lcg-l/HTDW_Opendog/urdf模型/xlerobot/xlerobot-HT 物料明细表.XLSX

xlerobot-HT 物料清单
序号 | !缩略图 | !文件名 | !统计数量 | 零件类型 | 零件数量
1 |  | link2 | 1
2 |  | 5036-02-正装 | 1
3 |  | Link2_Cover_A_V2.0 | 1
4 |  | 4438_model | 3
5 |  | 4438_Stator_block_1 | 3
6 |  | Link2_Connect_1免弯折 | 1
7 |  | Link2_Connect_2免弯折 | 1
8 |  | Link2_Cover_B_V2.0免弯折 | 1
9 |  | Bearing30x37x4
10 |  | 4438_Stator_block_B_2 | 3
11 |  | link1 | 1
12 |  | Link1_Connect_1 | 1
13 |  | Link1_Connect_2 | 1
14 |  | L1_Inner_circle_B | 1
15 |  | Link1_L1_D | 1
16 |  | 4438_Rotor_block_1 | 3
17 |  | 4438_Stator_block_B | 3
18 |  | link3 | 1
19 |  | Link3_Connect_3 | 1
20 |  | Link3_Connect_1免弯折 | 1
21 |  | Link3_Connect_2免弯折 | 1
22 |  | Link3_Connect_B3免折弯 | 1
23 |  | link4 | 1
24 |  | Link4_Connect_1 | 1
25 |  | 3536_model | 2
26 |  | Link4_libe_buckle | 1
27 |  | link5 | 1
28 |  | Link6_Connect_1 | 1
29 |  | Link5_Connect_3 | 1
30 |  | 2×6销轴 | 1
31 |  | Link5_Connect_2改件 | 1
32 |  | link6 | 1
33 |  | Gripper_Assembly | 1
34 |  | Gripper_Connect_B | 1
35 |  | hightorque3536 | 1
36 |  | MGN9-C | 2
37 |  | MGN9 Rail | 1
38 |  | Gripper_Connect_C | 2
39 |  | Gripper_Connect_D | 2
40 |  | Shoulder_Bolt_4xM3x7 | 4
41 |  | Flanged_Bearing4x9x2.5 | 8
42 |  | Gripper_Connect_A | 1
43 |  | Gripper_finger_Flexible_umi | 2
44 |  | hex_socket_flat_head_M3x08 | 4
45 |  | hex_socket_low_button_head_M3x8 | 3
46 |  | hex_socket_low_button_head_M3x5 | 8
47 |  | gripper_connect_R | 1
48 |  | gripper_connect_L | 1
49 |  | Gripper_Connect_E1.1 | 2
50 |  | RealSense_D405 | 1
51 |  | L6_Claw_insertsB | 1
52 |  | L6_Claw_insertsC | 1
53 |  | L6_Claw_insertsA | 1
54 |  | Link1_L6_A- | 1
55 |  | Gripper-Camera_Connect_A- | 1
56 |  | Gripper_Connect_F- | 1
57 |  | base_link | 1
58 |  | Baselink_1 | 1
59 |  | Baselink_C-3.0 | 1
60 |  | L1_Inner_circleV2.0 | 1
61 |  | 底座带新LOGO丝印- | 1
62 |  | HTDW-4530-02-CNE | 1
63 |  | HTDW-4530-02-CNE.STEP | 1
64 |  | 4438外壳03192.0.STEP | 1
65 |  | 4438-电机盖-2.1.STEP | 1
66 |  | 4438-jc轴承座-1.3.STEP | 1
67 |  | 4438-jc输出盘.STEP | 1
68 |  | CRBT305A 30-41-5交叉滚子轴承.STEP | 1
69 |  | 2内齿44382.0.STEP | 1
70 |  | 3D_双编-4438-V1.9_2025-03-042.0.STEP | 1
71 |  | 4438输出编码器销2.0_35.5.STEP | 1
72 |  | M2.5-10-3.7杯头螺丝.STEP | 4
73 |  | m2-4-3十字沉头螺丝.STEP | 4
74 |  | 30-40-3旋转油封.STEP | 1
