lcg-l/HTDW_Opendog/四足-姚旋-5套/四足-姚旋-5套.xlsx

零件名称： |  |  |  | 备注
输出人： | 姚旋
输出时间： | 2026-09-01
零件级别 | 零件名称 | 图样 | 单套数量 | 套数 | 总数量 | 材质名称 | 备注
 | 大腿内侧-L |  | 2 | 5 | 10 | 6061合金
 | 大腿内侧-R |  | 2 | 5 | 10 | 6061合金
 | 大腿外侧-L |  | 2 | 5 | 10 | 6061合金
 | 大腿外侧-R |  | 2 | 5 | 10 | 6061合金
 | 4530快拆法兰-A |  | 8 | 5 | 40 | 6061合金
 | 横梁 |  | 2 | 5 | 10 | 6061合金
 | 髋关节快拆 |  | 4 | 5 | 20 | 6061合金
 | 钢连杆 |  | 4 | 5 | 20 | 7075合金
 | 箱体侧板 |  | 2 | 5 | 10 | 6061合金
 | 摇臂 |  | 4 | 5 | 20 | 45钢
 | 4530快拆法兰-B |  | 8 | 5 | 40 | 6061合金
 | 4530快拆法兰-C |  | 4 | 5 | 20 | 6061合金
 | 钣金快拆 |  | 2 | 5 | 10 | 镀锌板
 | 限位块 |  | 8 | 5 | 40 | 6061合金
 | 大腿限位块 |  | 8 | 5 | 40 | 6061合金
 | 钣金快拆垫块 |  | 4 | 5 | 20 | 6061合金
