lcg-l/HTDW_Opendog/urdf模型/xlerobot/forearm_link.SLDASM

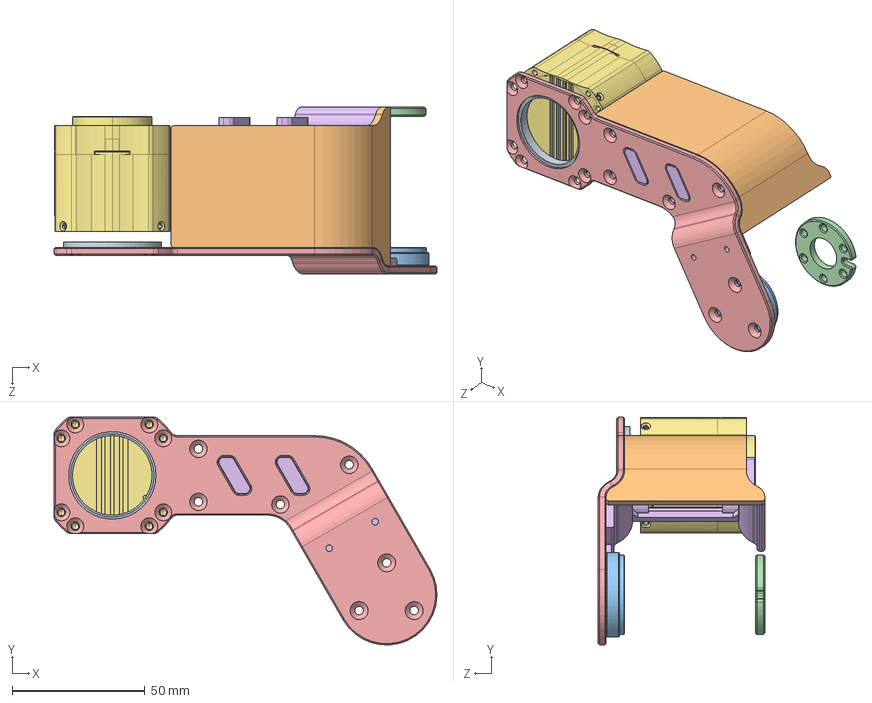
[picture p1: CAD file, 2026-08-31]
urdf模型/xlerobot/forearm_link.SLDASM
144.5 x 86.0 x 62.9 mm
4438_model
Link3_Connect_3
Link3_Connect_1免弯折
4438_Rotor_block_1
4438_Stator_block_B
Link3_Connect_B3免折弯
Bearing30x37x4
