lcg-l/HTDW_Opendog/模型/hip.SLDASM

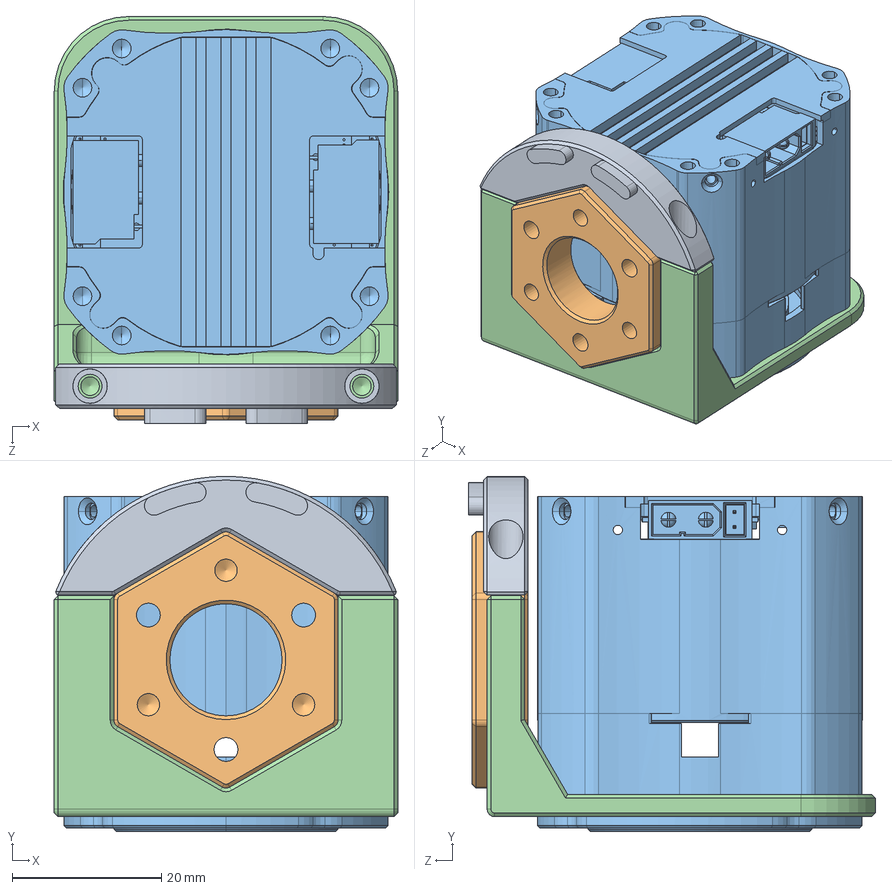
[picture p2: CAD file, 2026-08-31]
模型/hip.SLDASM
46.0 x 47.6 x 54.5 mm
髋关节快拆
4438-JC正装模型
4530快拆法兰-A
4530快拆法兰-B
