lcg-l/HTDW_Opendog/ri_4438/meshes/base_link_part_2.STL

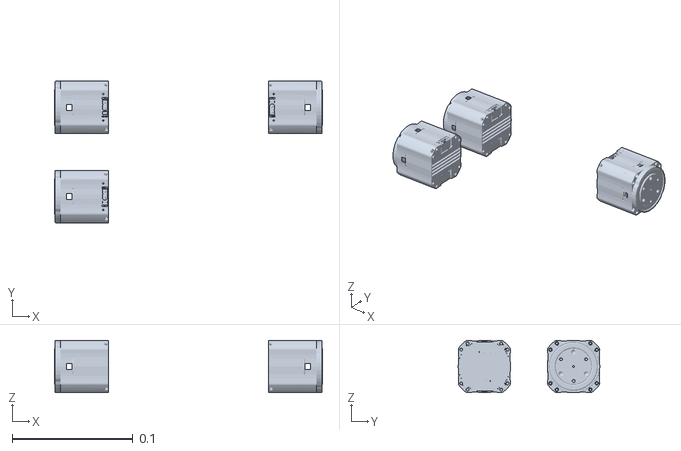
[picture p3: CAD file, 2026-08-03]
ri_4438/meshes/base_link_part_2.STL
0.222 x 0.117 x 0.0435
