lcg-l/HTDW_Opendog/ri_plus_4438/meshes/gripper_finger_right.STL

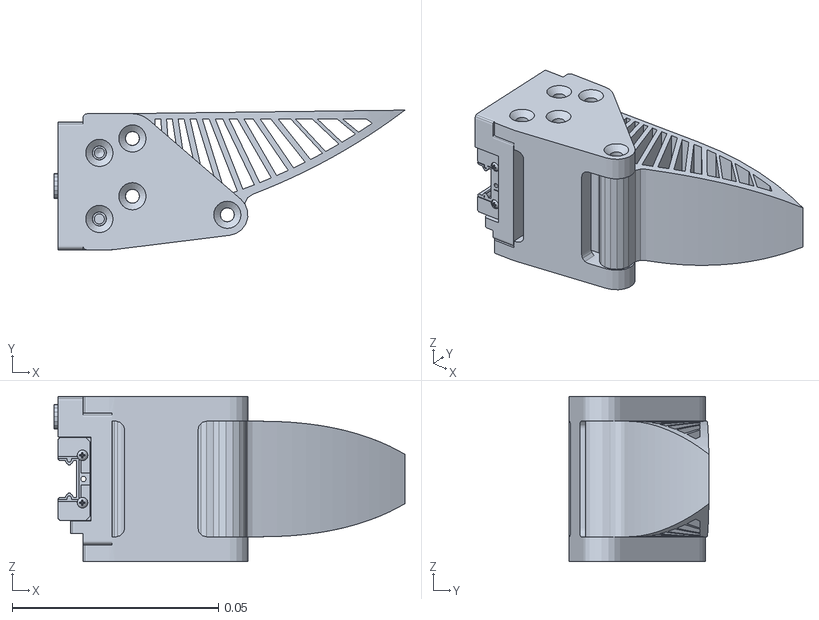
[picture p4: CAD file, 2026-08-04]
ri_plus_4438/meshes/gripper_finger_right.STL
0.0851 x 0.0339 x 0.04
