lcg-l/HTDW_Opendog/urdf/小腿.SLDPRT

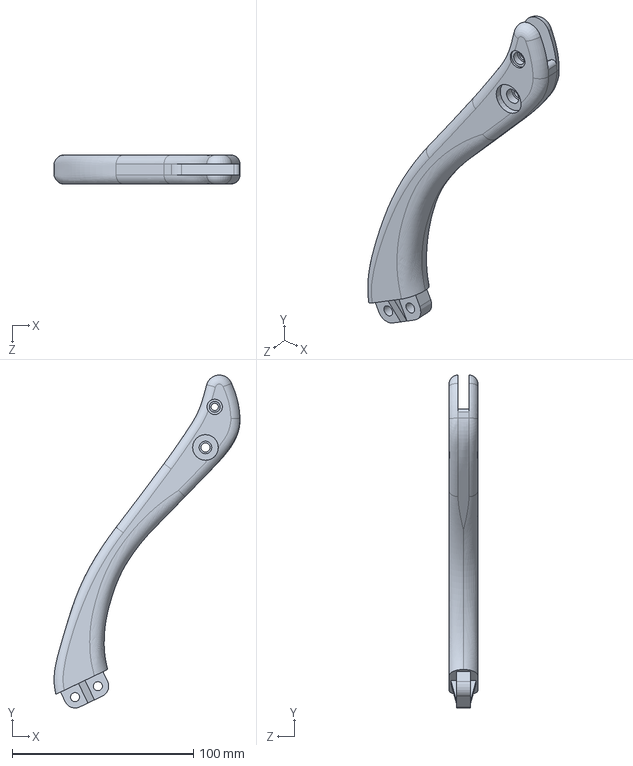
[picture p5: CAD file, 2026-07-23]
urdf/小腿.SLDPRT
102.7 x 183.9 x 16.0 mm
