lcg-l/HTDW_Opendog/urdf模型/箱体侧板.SLDPRT

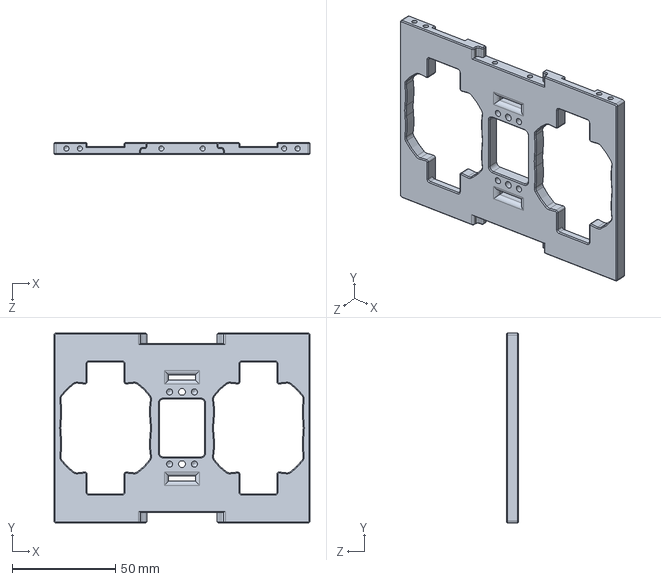
[picture p6: CAD file, 2026-09-02]
urdf模型/箱体侧板.SLDPRT
124.0 x 92.0 x 6.00 mm
