lcg-l/HTDW_Opendog/四足-姚旋-5套/step/箱体侧板.step

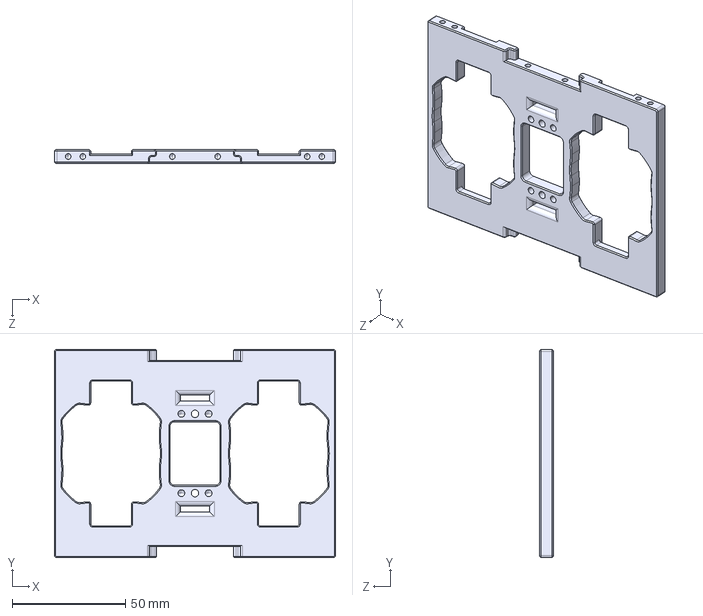
[picture p7: CAD file, 2026-09-02]
四足-姚旋-5套/step/箱体侧板.step
124.0 x 92.0 x 6.00 mm
