lcg-l/HTDW_Opendog/模型/摇臂.SLDPRT

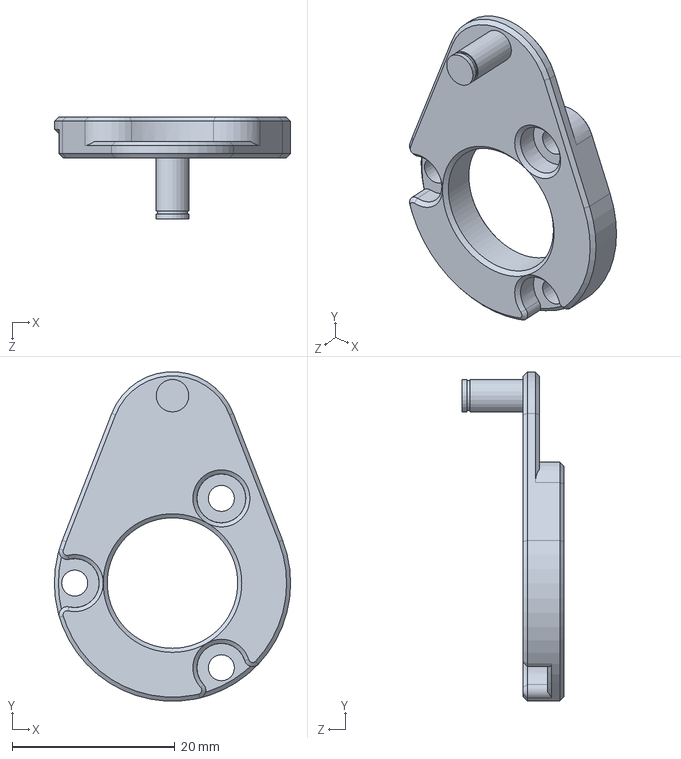
[picture p8: CAD file, 2026-09-02]
模型/摇臂.SLDPRT
29.0 x 40.4 x 12.5 mm
