lcg-l/HTDW_Opendog/ri_4438/meshes/base_link_part_1.STL

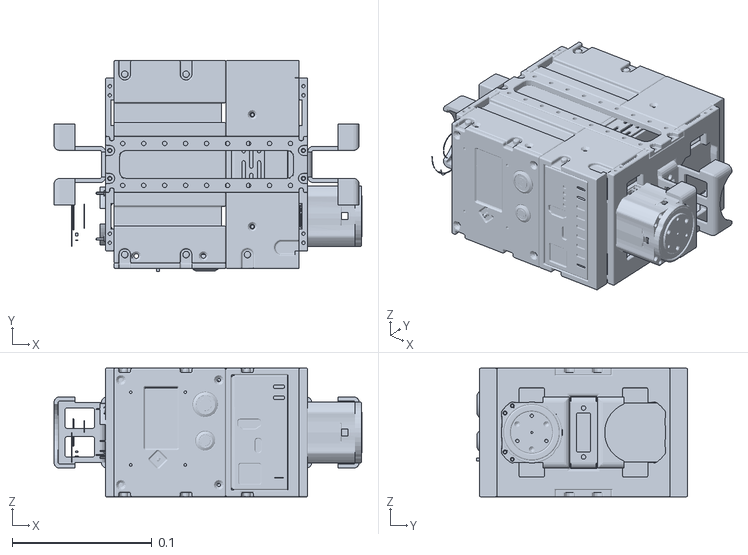
[picture p9: CAD file, 2026-08-03]
ri_4438/meshes/base_link_part_1.STL
0.22 x 0.151 x 0.092
