lcg-l/HTDW_Opendog/ri_plus_4438/meshes/wrist3_link.STL

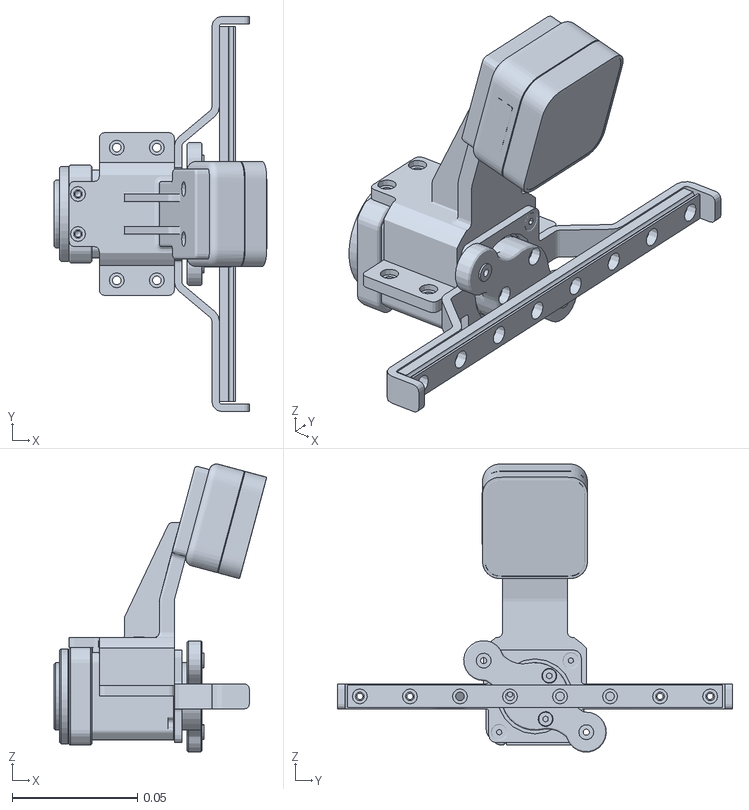
[picture p10: CAD file, 2026-08-04]
ri_plus_4438/meshes/wrist3_link.STL
0.0849 x 0.158 x 0.115
