lcg-l/HTDW_Opendog/四足-姚旋-5套/step/钣金快拆.step

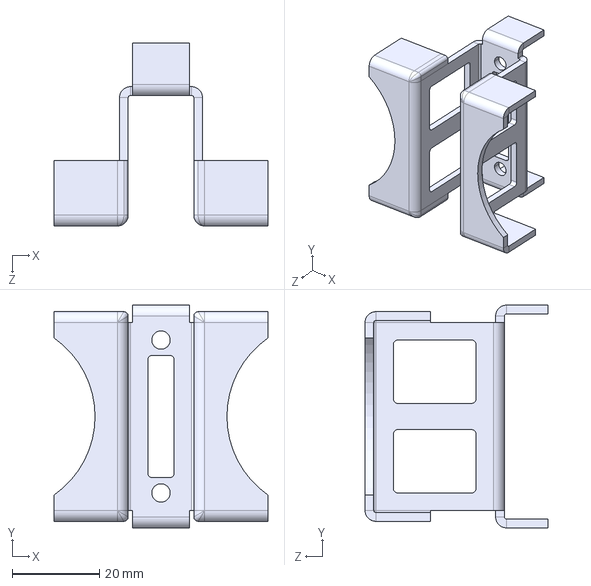
[picture p11: CAD file, 2026-09-02]
四足-姚旋-5套/step/钣金快拆.step
49.0 x 51.0 x 41.9 mm
