lcg-l/HTDW_Opendog/模型/xlerobot/Gripper_Connect_F-.SLDPRT

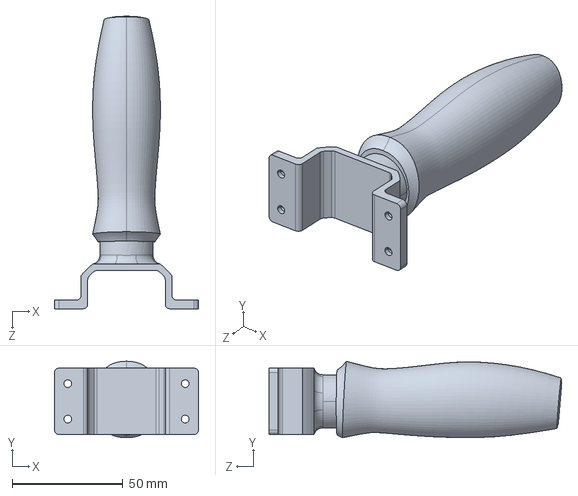
[picture p12: CAD file, 2026-07-28]
模型/xlerobot/Gripper_Connect_F-.SLDPRT
65.0 x 34.5 x 132.1 mm
