lcg-l/HTDW_Opendog/ri_4438/meshes/RR_hip.STL

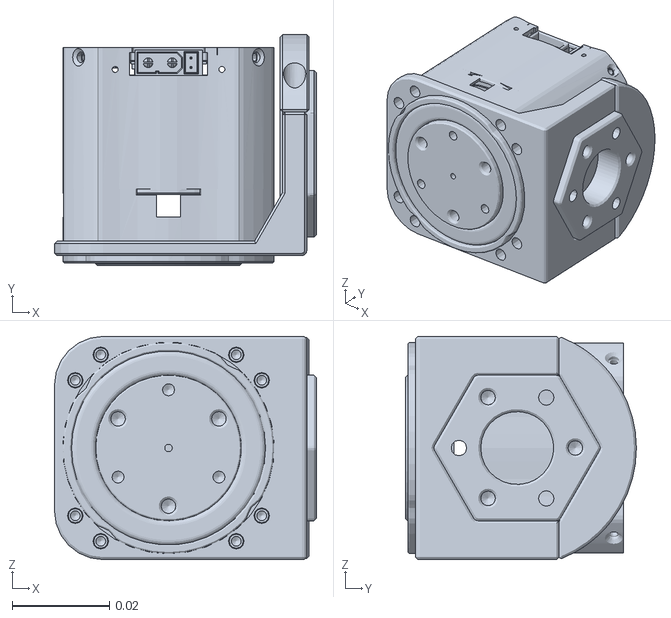
[picture p13: CAD file, 2026-07-26]
ri_4438/meshes/RR_hip.STL
0.054 x 0.0476 x 0.046
