lcg-l/HTDW_Opendog/urdf模型/xlerobot/Link3_Connect_B3免折弯.SLDPRT

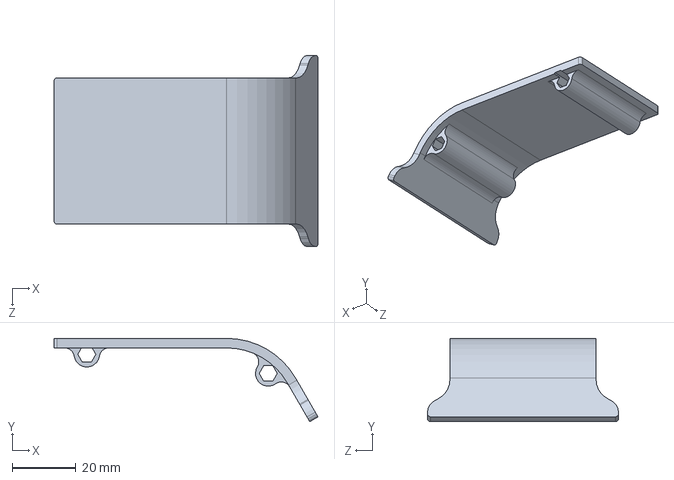
[picture p14: CAD file, 2026-08-31]
urdf模型/xlerobot/Link3_Connect_B3免折弯.SLDPRT
82.8 x 26.1 x 59.9 mm
