lcg-l/HTDW_Opendog/四足-姚旋-5套/step/钣金快拆垫块.STEP

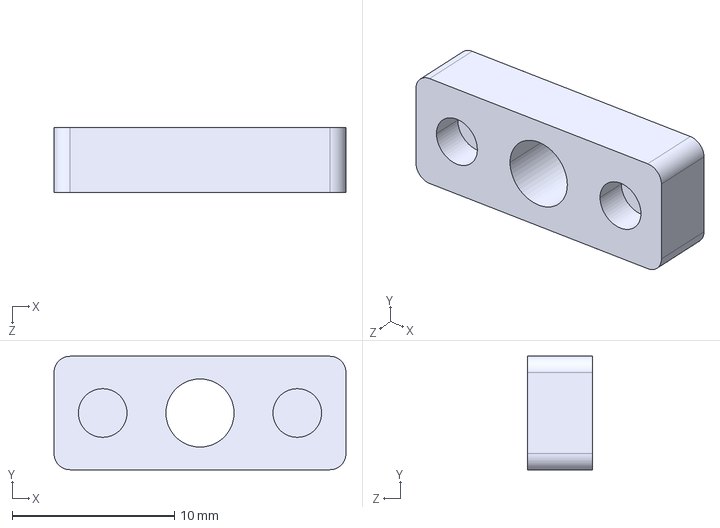
[picture p15: CAD file, 2026-09-02]
四足-姚旋-5套/step/钣金快拆垫块.STEP
18.0 x 7.00 x 4.00 mm
