lcg-l/HTDW_Opendog/模型/xlerobot/Gripper_Connect_D.SLDPRT

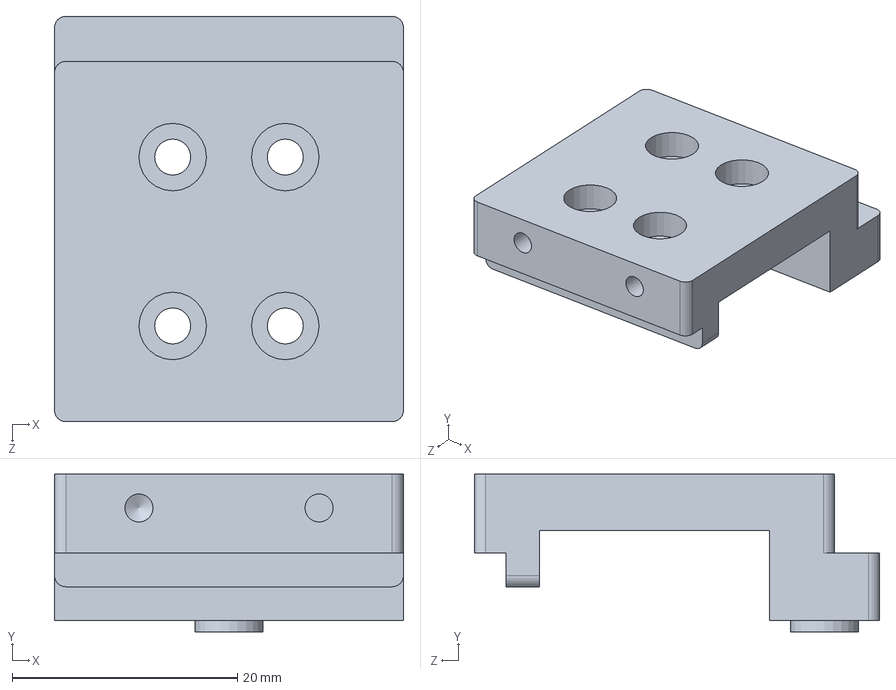
[picture p16: CAD file, 2026-07-28]
模型/xlerobot/Gripper_Connect_D.SLDPRT
31.0 x 14.0 x 36.0 mm
