lcg-l/HTDW_Opendog/ri_4438/meshes/FL_foot.STL

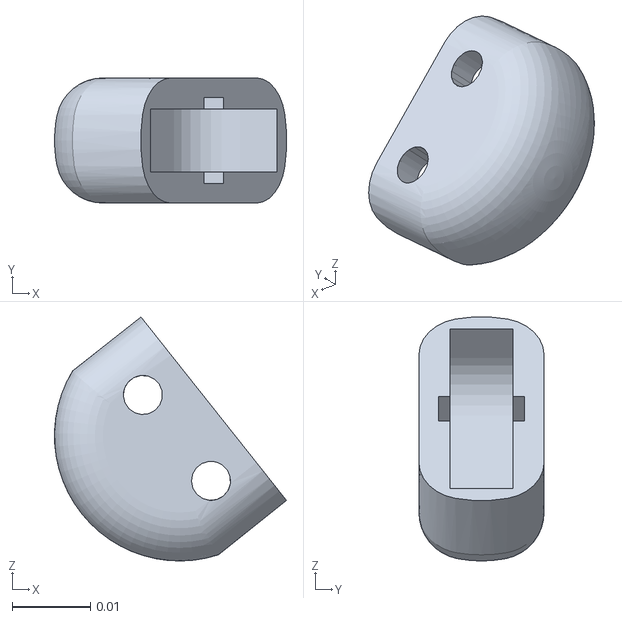
[picture p17: CAD file, 2026-07-26]
ri_4438/meshes/FL_foot.STL
0.0296 x 0.016 x 0.0312
