lcg-l/HTDW_Opendog/ri_plus_4438/meshes/FR_calf.STL

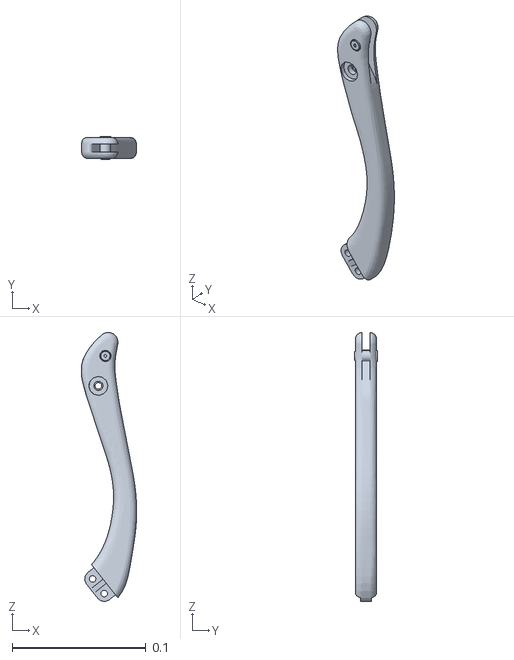
[picture p18: CAD file, 2026-08-04]
ri_plus_4438/meshes/FR_calf.STL
0.0415 x 0.017 x 0.201
