lcg-l/HTDW_Opendog/urdf模型/xlerobot/Link3_Connect_3.SLDPRT

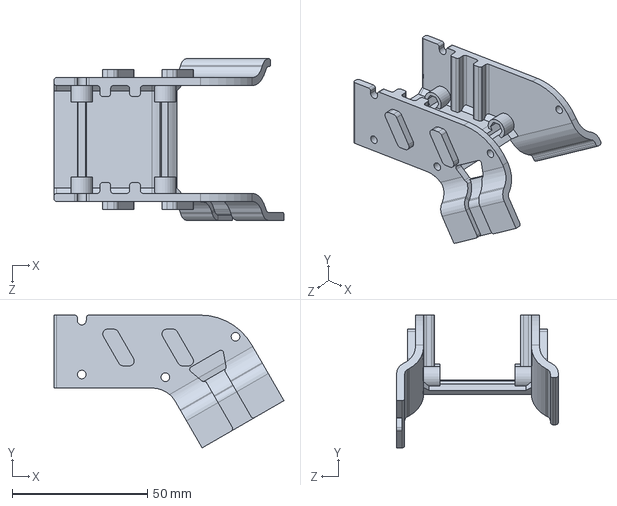
[picture p19: CAD file, 2026-08-31]
urdf模型/xlerobot/Link3_Connect_3.SLDPRT
85.2 x 49.2 x 59.9 mm
