lcg-l/HTDW_Opendog/ri_plus_4438/meshes/FR_hip.STL

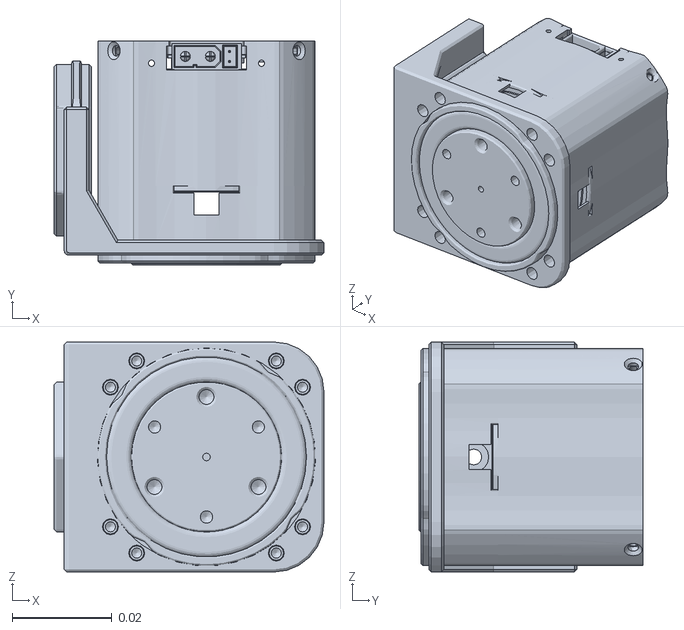
[picture p21: CAD file, 2026-08-04]
ri_plus_4438/meshes/FR_hip.STL
0.054 x 0.0449 x 0.046
