lcg-l/HTDW_Opendog/模型/xlerobot/L6_Claw_insertsC.SLDPRT

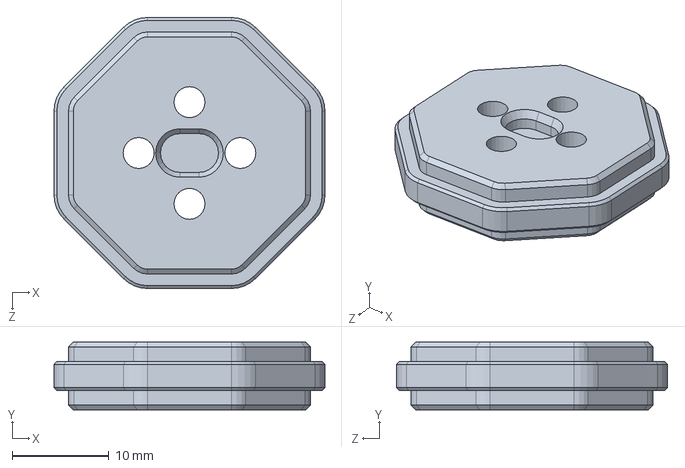
[picture p23: CAD file, 2026-07-28]
模型/xlerobot/L6_Claw_insertsC.SLDPRT
28.0 x 7.00 x 28.0 mm
