lcg-l/HTDW_Opendog/四足-姚旋-5套/step/髋关节快拆.step

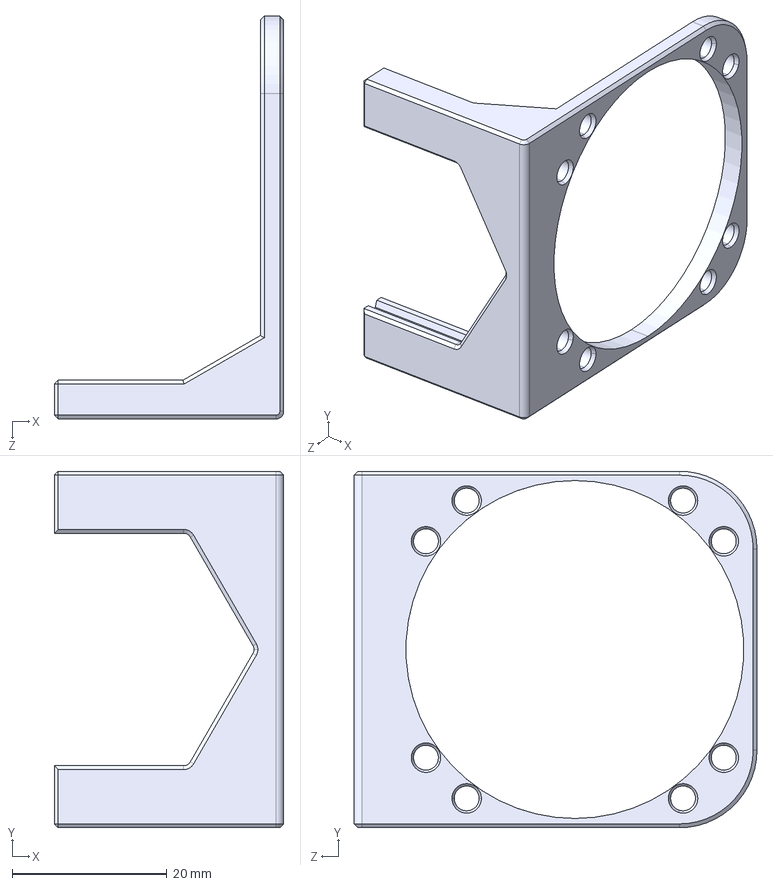
[picture p24: CAD file, 2026-08-31]
四足-姚旋-5套/step/髋关节快拆.step
29.6 x 46.0 x 52.0 mm
