lcg-l/HTDW_Opendog/模型/xlerobot/4438_model.SLDPRT

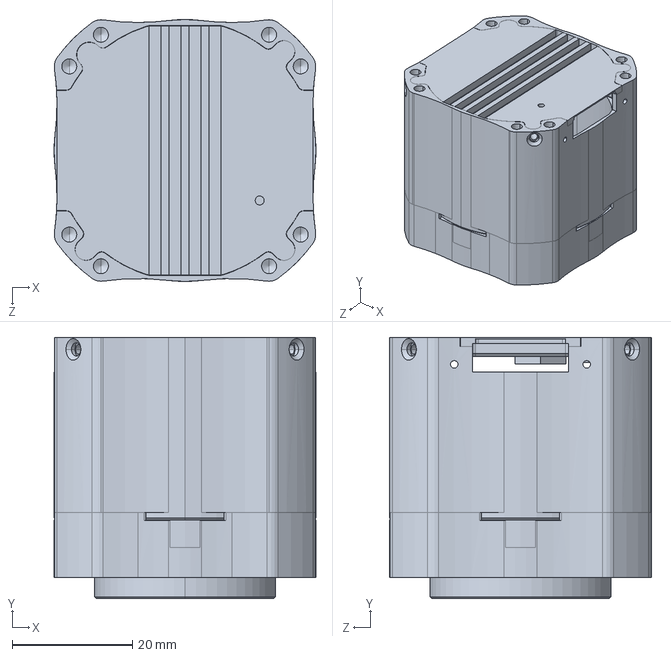
[picture p25: CAD file, 2026-07-28]
模型/xlerobot/4438_model.SLDPRT
43.5 x 43.4 x 43.5 mm
