lcg-l/HTDW_Opendog/urdf模型/大腿外侧-R.SLDPRT

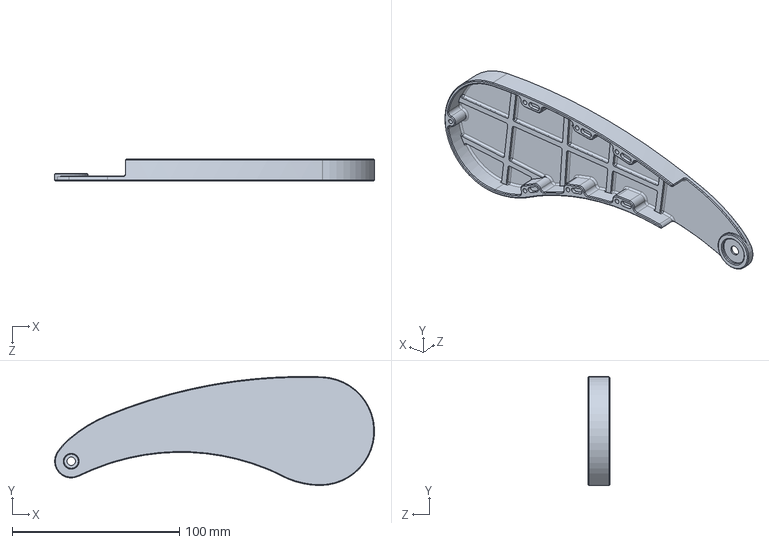
[picture p26: CAD file, 2026-08-31]
urdf模型/大腿外侧-R.SLDPRT
191.4 x 65.2 x 13.0 mm
