lcg-l/HTDW_Opendog/四足-姚旋-5套/step/4530快拆法兰-B.step

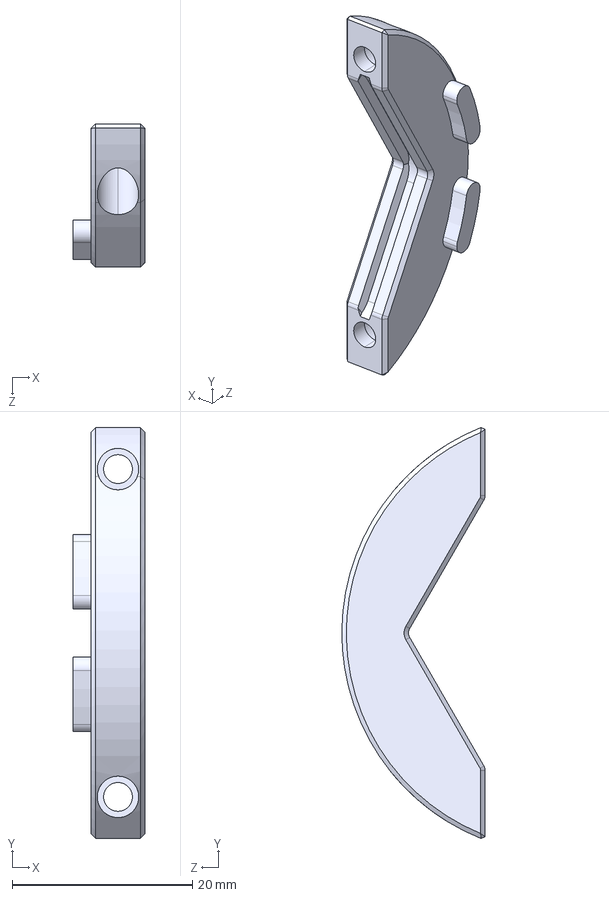
[picture p27: CAD file, 2026-08-31]
四足-姚旋-5套/step/4530快拆法兰-B.step
8.00 x 45.6 x 15.9 mm
