lcg-l/HTDW_Opendog/模型/xlerobot/4438_Stator_block_2.SLDPRT

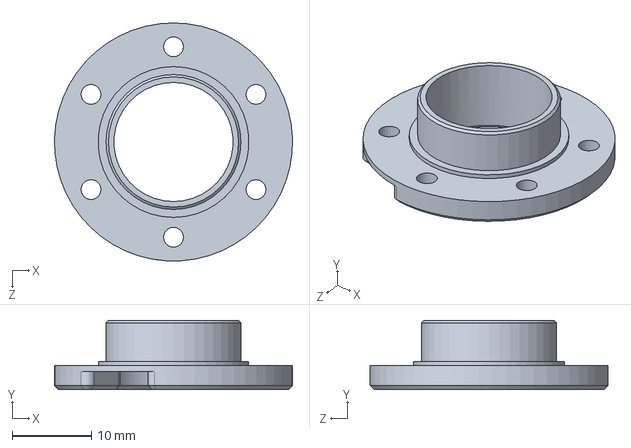
[picture p28: CAD file, 2026-07-28]
模型/xlerobot/4438_Stator_block_2.SLDPRT
30.0 x 8.70 x 30.0 mm
