lcg-l/HTDW_Opendog/ri_4438/meshes/FL_thigh.STL

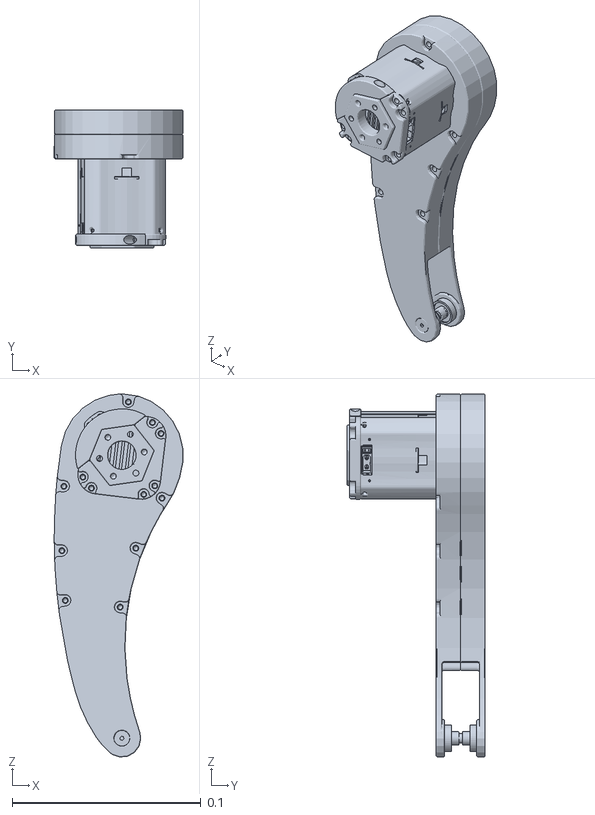
[picture p29: CAD file, 2026-07-26]
ri_4438/meshes/FL_thigh.STL
0.0682 x 0.0734 x 0.192
