lcg-l/HTDW_Opendog/模型/4530快拆法兰-A.SLDPRT

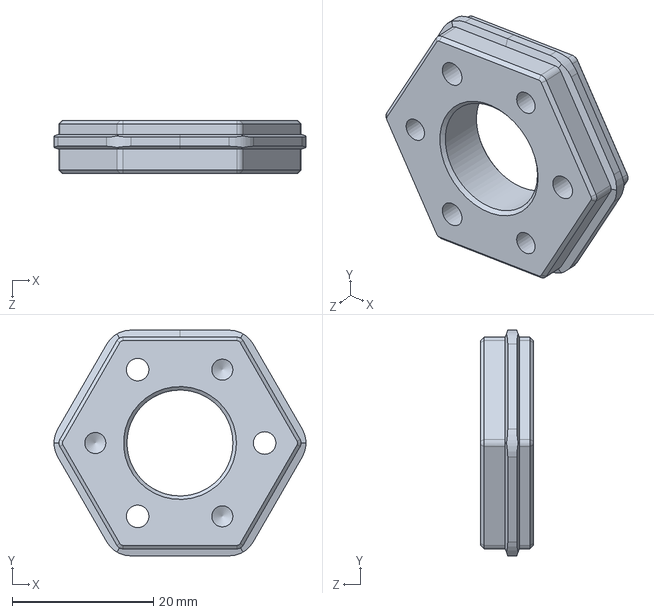
[picture p30: CAD file, 2026-09-02]
模型/4530快拆法兰-A.SLDPRT
35.7 x 32.0 x 7.50 mm
