lcg-l/HTDW_Opendog/模型/xlerobot/4438_Rotor_block_1.SLDPRT

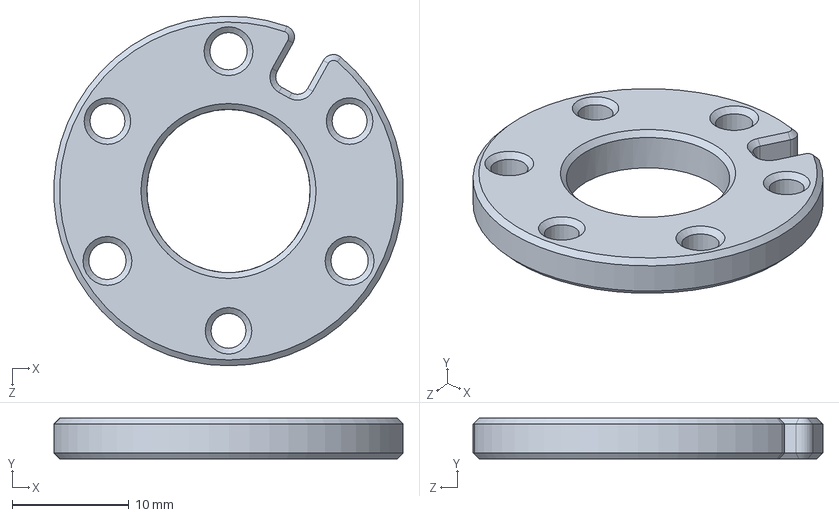
[picture p31: CAD file, 2026-07-28]
模型/xlerobot/4438_Rotor_block_1.SLDPRT
30.0 x 3.50 x 30.0 mm
