lcg-l/HTDW_Opendog/ri_plus_4438/meshes/xlerobot_base_link.STL

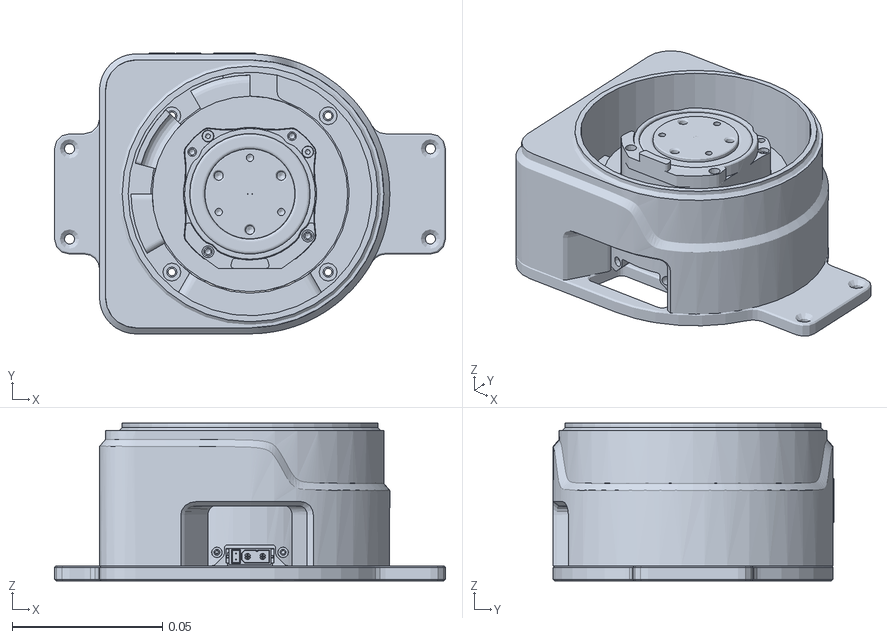
[picture p32: CAD file, 2026-08-04]
ri_plus_4438/meshes/xlerobot_base_link.STL
0.13 x 0.0933 x 0.0525
