lcg-l/HTDW_Opendog/四足-姚旋-5套/step/大腿内侧-L.step

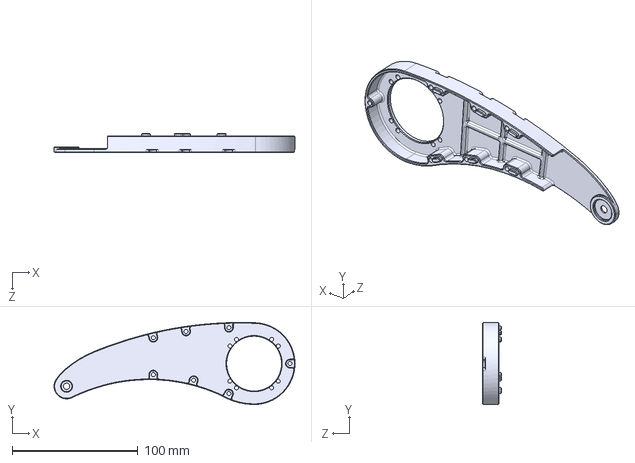
[picture p33: CAD file, 2026-07-28]
四足-姚旋-5套/step/大腿内侧-L.step
191.4 x 65.2 x 15.0 mm
