lcg-l/HTDW_Opendog/模型/xlerobot/Gripper_Connect_E1.1.SLDPRT

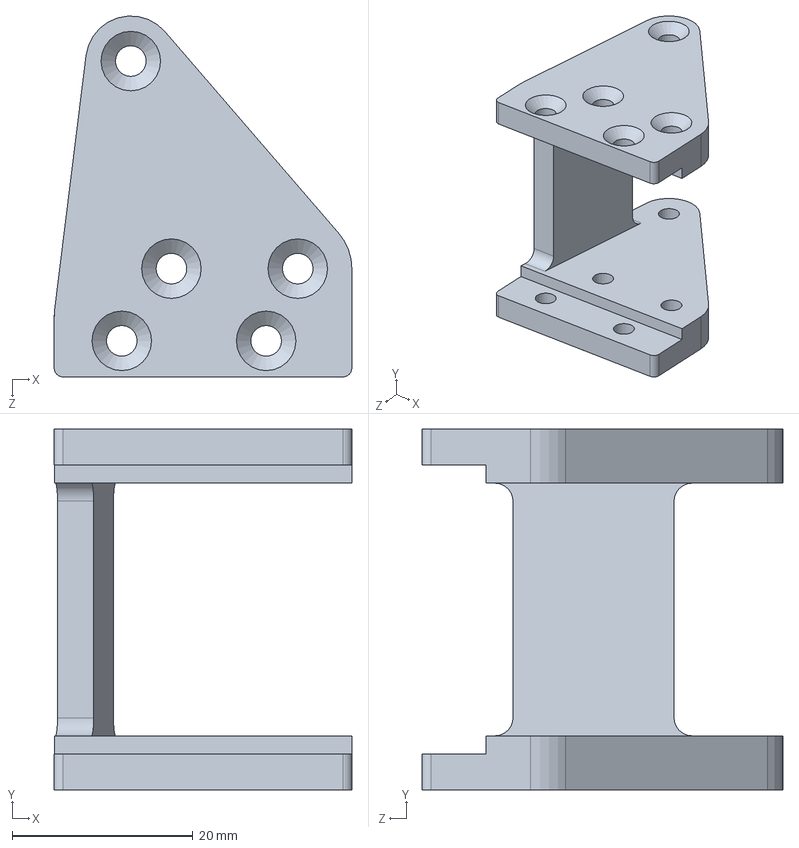
[picture p34: CAD file, 2026-07-28]
模型/xlerobot/Gripper_Connect_E1.1.SLDPRT
33.0 x 40.0 x 40.0 mm
