lcg-l/HTDW_Opendog/ri_plus_4438/meshes/wrist2_link.STL

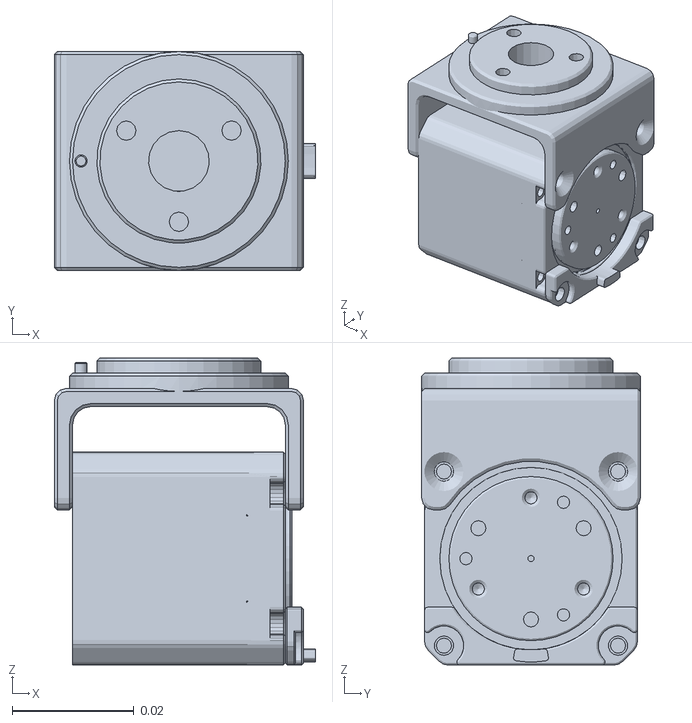
[picture p35: CAD file, 2026-08-04]
ri_plus_4438/meshes/wrist2_link.STL
0.043 x 0.036 x 0.0505
