lcg-l/HTDW_Opendog/模型/xlerobot/Bearing30x37x4.SLDPRT

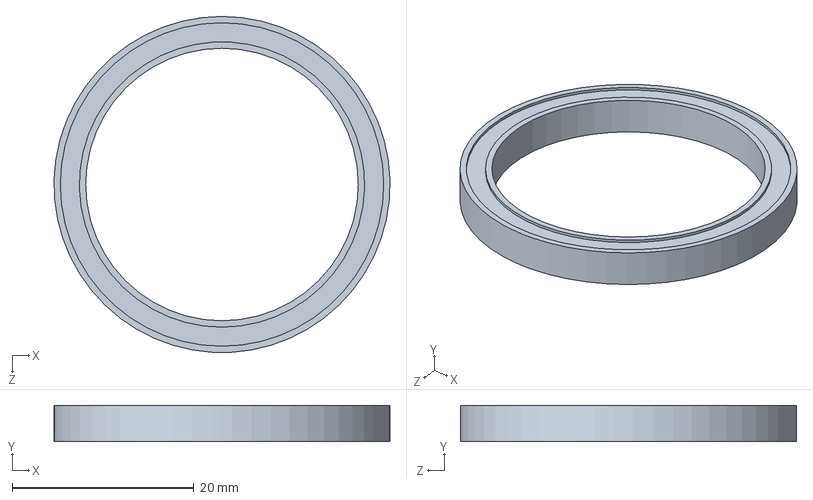
[picture p38: CAD file, 2026-07-28]
模型/xlerobot/Bearing30x37x4.SLDPRT
37.0 x 4.00 x 37.0 mm
