lcg-l/HTDW_Opendog/模型/xlerobot/4438_Stator_block_B.SLDPRT

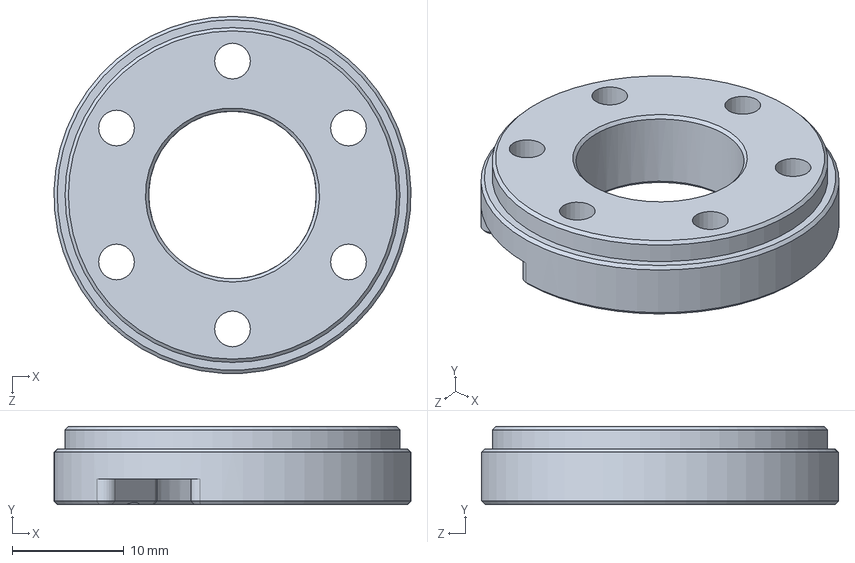
[picture p40: CAD file, 2026-07-28]
模型/xlerobot/4438_Stator_block_B.SLDPRT
32.0 x 7.00 x 32.0 mm
