lcg-l/HTDW_Opendog/四足-姚旋-5套/step/摇臂.step

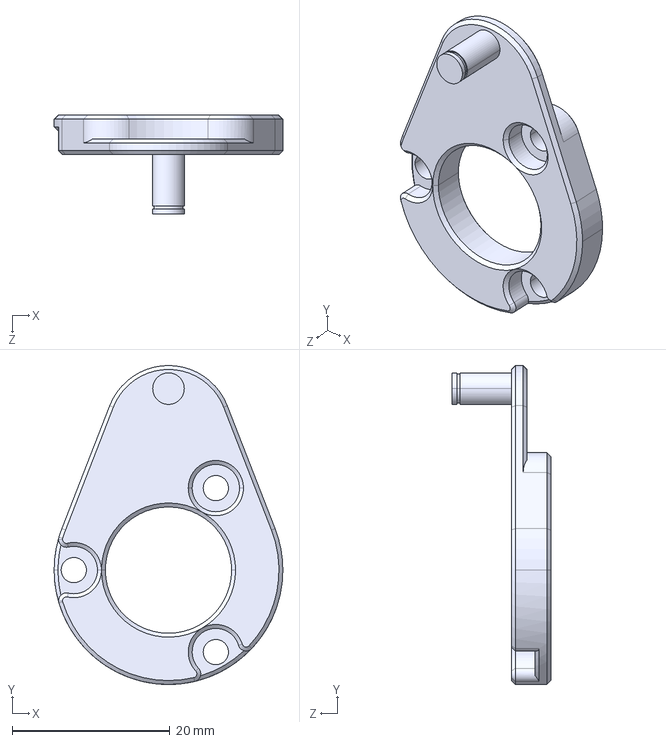
[picture p41: CAD file, 2026-07-28]
四足-姚旋-5套/step/摇臂.step
29.0 x 40.4 x 12.5 mm
