lcg-l/HTDW_Opendog/模型/xlerobot/L6_Claw_insertsB.SLDPRT

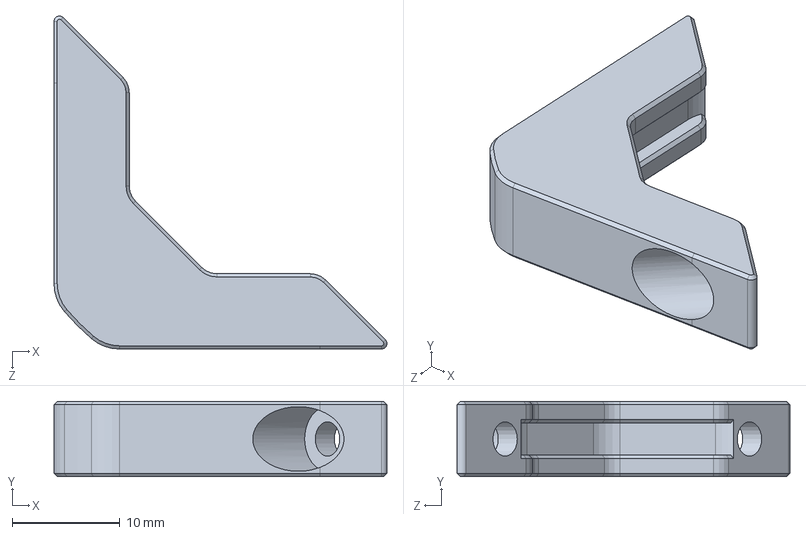
[picture p42: CAD file, 2026-07-28]
模型/xlerobot/L6_Claw_insertsB.SLDPRT
31.0 x 7.00 x 31.0 mm
