lcg-l/HTDW_Opendog/ri_plus_4438/meshes/base_link.STL

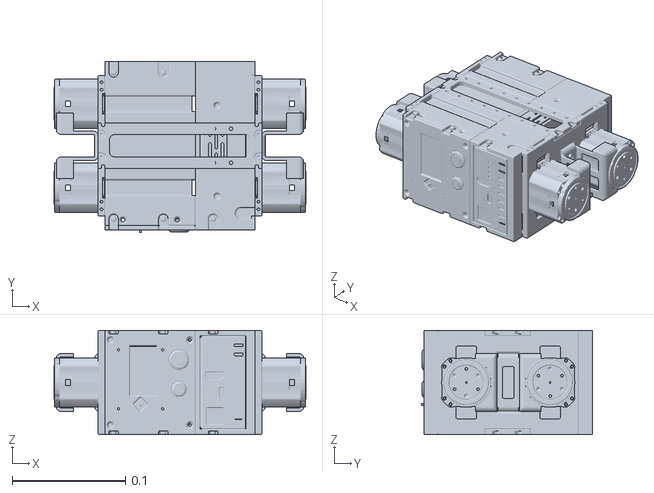
[picture p43: CAD file, 2026-08-04]
ri_plus_4438/meshes/base_link.STL
0.222 x 0.151 x 0.092
