lcg-l/HTDW_Opendog/urdf模型/髋关节快拆.SLDPRT

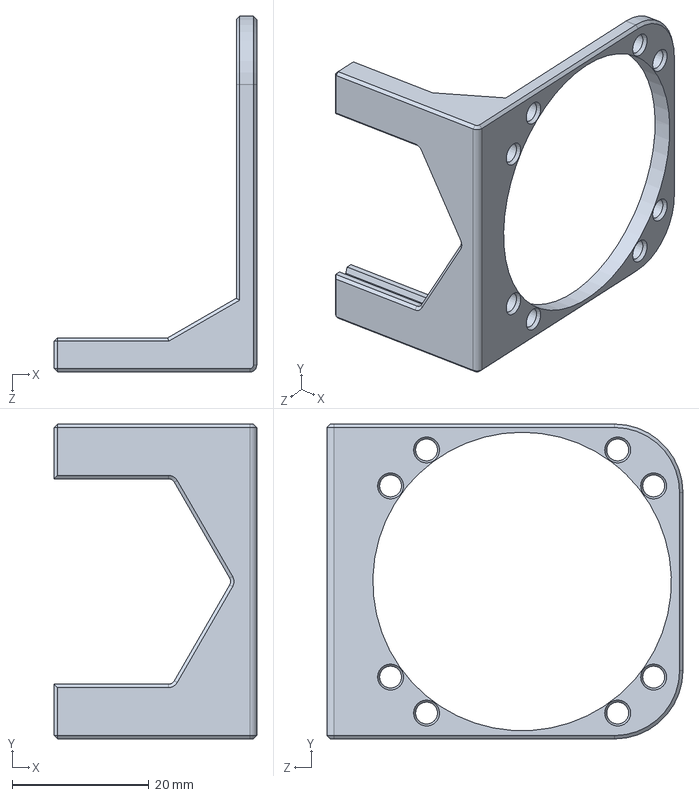
[picture p44: CAD file, 2026-08-31]
urdf模型/髋关节快拆.SLDPRT
29.6 x 46.0 x 52.0 mm
