lcg-l/HTDW_Opendog/模型/xlerobot/Link1_Connect_2.SLDPRT

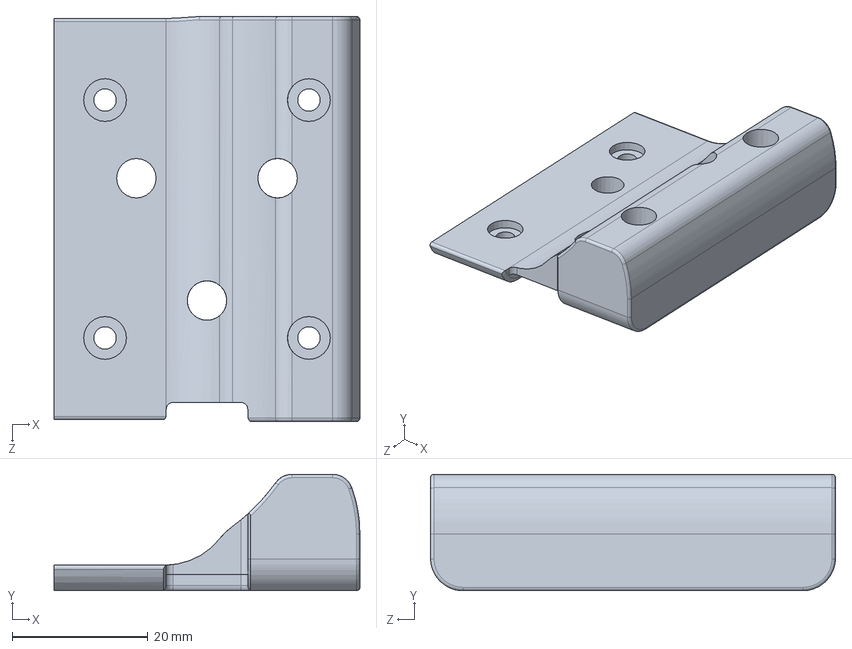
[picture p45: CAD file, 2026-07-28]
模型/xlerobot/Link1_Connect_2.SLDPRT
45.0 x 17.1 x 59.6 mm
