lcg-l/HTDW_Opendog/urdf模型/xlerobot/Link3_Connect_B3.SLDPRT

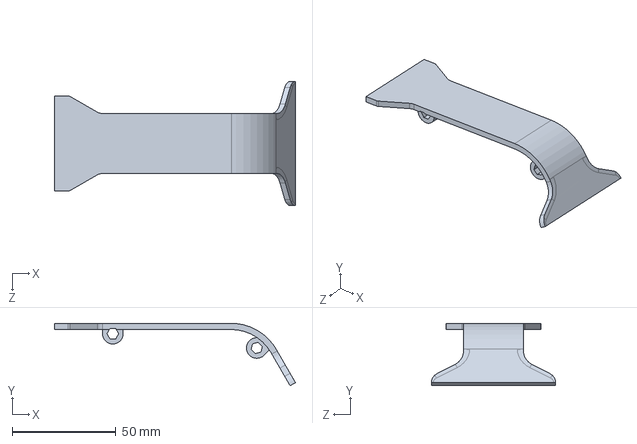
[picture p46: CAD file, 2026-07-28]
urdf模型/xlerobot/Link3_Connect_B3.SLDPRT
116.1 x 30.1 x 59.9 mm
