lcg-l/HTDW_Opendog/模型/xlerobot/内六角锥形沉头螺钉 M3x8.SLDPRT

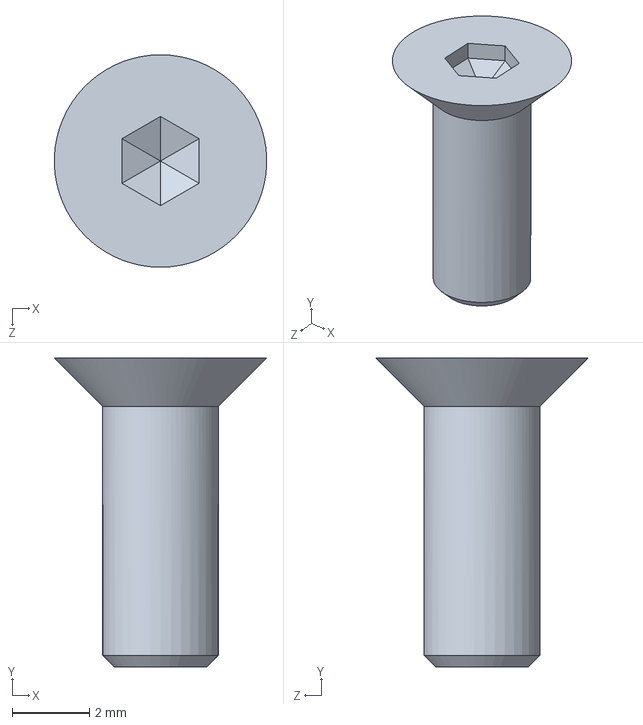
[picture p47: CAD file, 2026-07-28]
模型/xlerobot/内六角锥形沉头螺钉 M3x8.SLDPRT
5.49 x 8.00 x 5.50 mm
