lcg-l/HTDW_Opendog/urdf模型/xlerobot/Gripper_Connect_G.SLDPRT

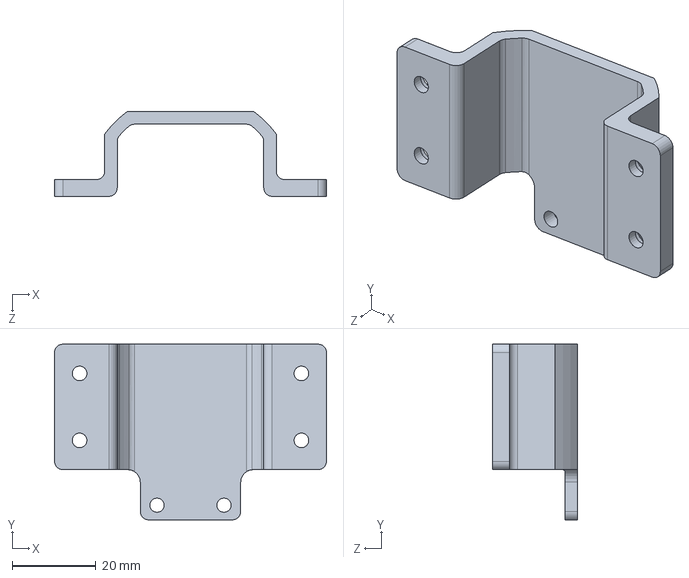
[picture p48: CAD file, 2026-07-28]
urdf模型/xlerobot/Gripper_Connect_G.SLDPRT
65.0 x 42.0 x 20.2 mm
