lcg-l/HTDW_Opendog/四足-姚旋-5套/step/4530快拆法兰-C.step

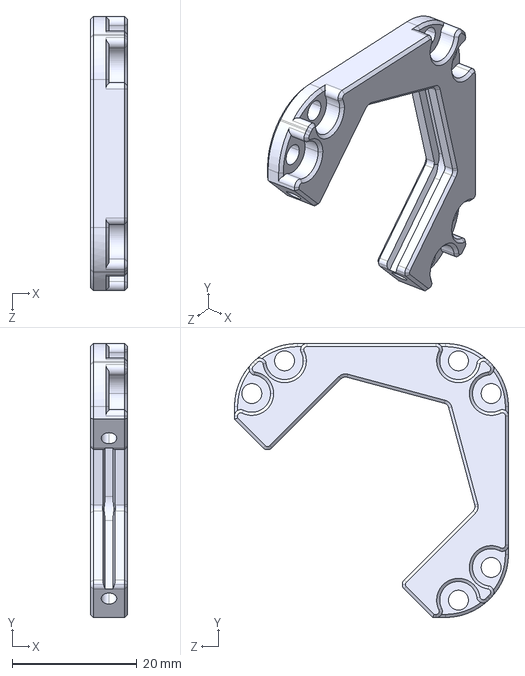
[picture p49: CAD file, 2026-07-28]
四足-姚旋-5套/step/4530快拆法兰-C.step
6.00 x 44.0 x 44.0 mm
