lcg-l/HTDW_Opendog/模型/4438-JC正装模型.SLDPRT

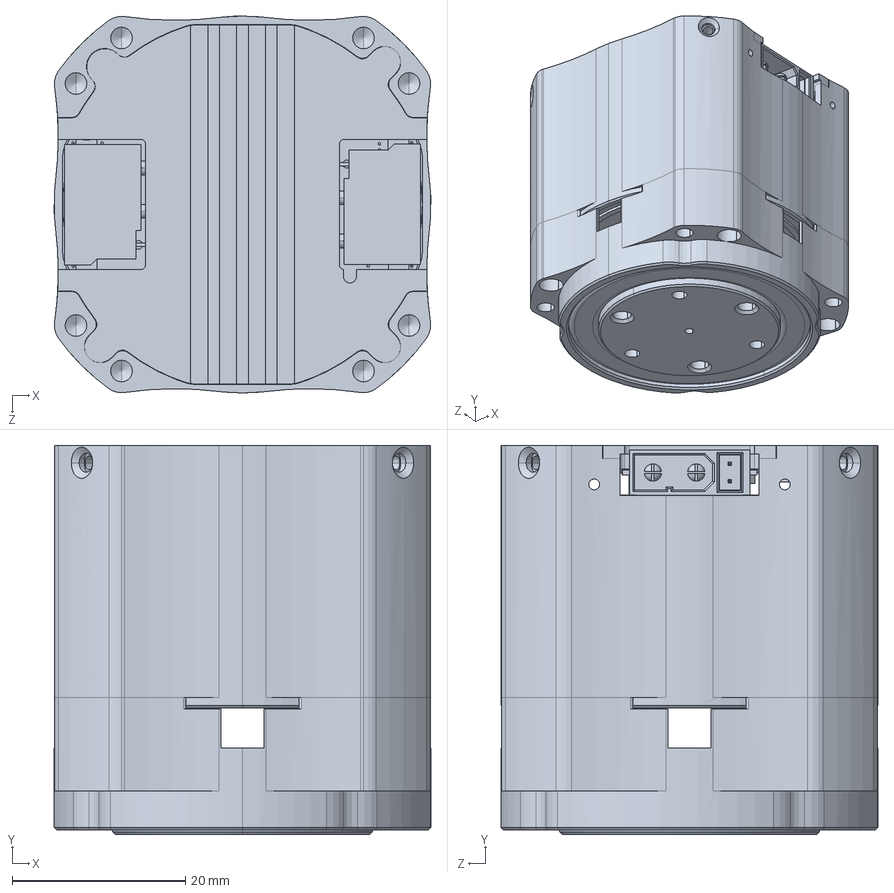
[picture p50: CAD file, 2026-08-31]
模型/4438-JC正装模型.SLDPRT
43.4 x 44.9 x 43.5 mm
