lcg-l/HTDW_Opendog/模型/xlerobot/Link6_Connect_1.SLDPRT

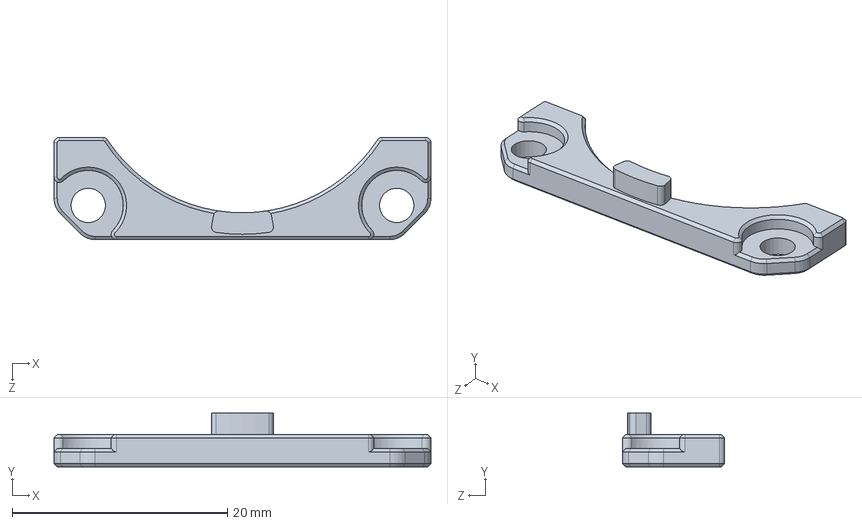
[picture p51: CAD file, 2026-07-28]
模型/xlerobot/Link6_Connect_1.SLDPRT
35.0 x 5.00 x 9.50 mm
