lcg-l/HTDW_Opendog/urdf模型/foot.SLDPRT

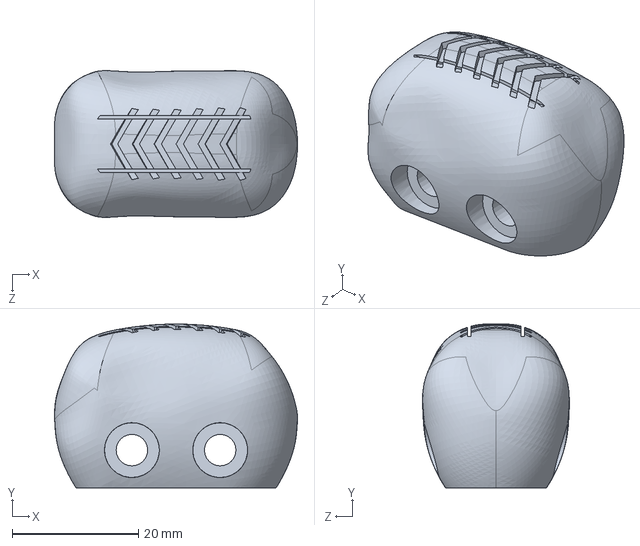
[picture p52: CAD file, 2026-08-06]
urdf模型/foot.SLDPRT
38.5 x 26.0 x 23.3 mm
