lcg-l/HTDW_Opendog/urdf模型/xlerobot/Link5_Connect_2改件.SLDPRT

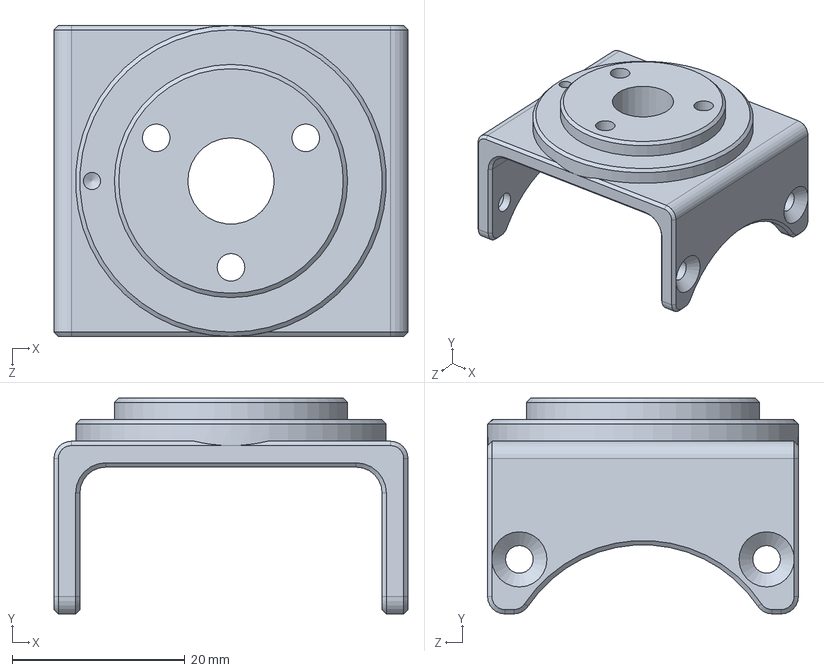
[picture p53: CAD file, 2026-07-28]
urdf模型/xlerobot/Link5_Connect_2改件.SLDPRT
41.0 x 25.0 x 36.0 mm
