lcg-l/HTDW_Opendog/模型/xlerobot/Baselink_C-3.0.SLDPRT

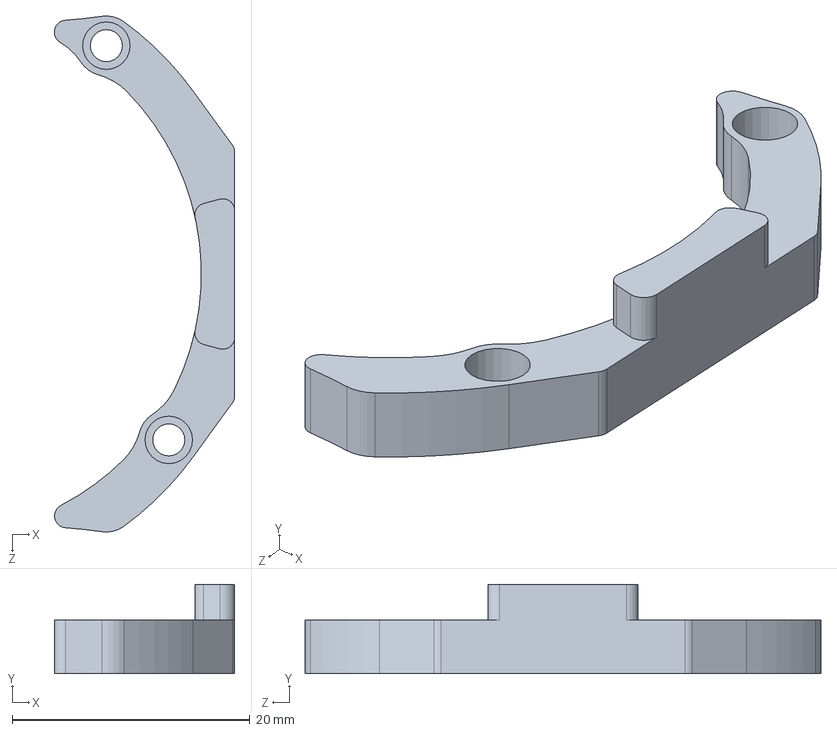
[picture p54: CAD file, 2026-07-28]
模型/xlerobot/Baselink_C-3.0.SLDPRT
15.2 x 7.50 x 43.4 mm
