lcg-l/HTDW_Opendog/ri_plus_4438/meshes/shoulder_link.STL

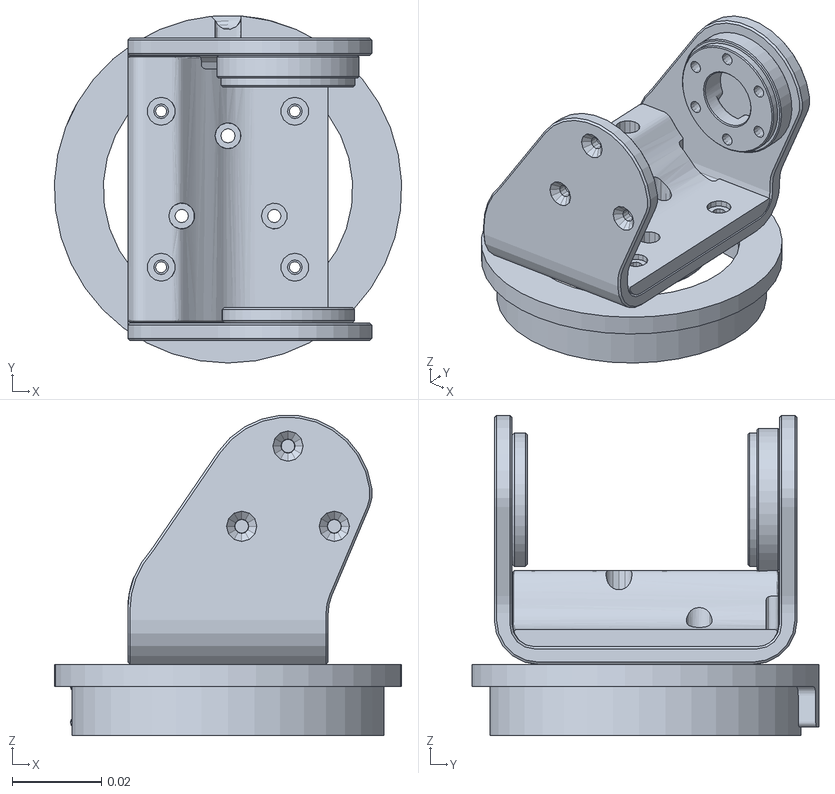
[picture p55: CAD file, 2026-08-04]
ri_plus_4438/meshes/shoulder_link.STL
0.0779 x 0.0779 x 0.0719
