lcg-l/HTDW_Opendog/urdf模型/xlerobot/Link3_Connect_1免弯折.SLDPRT

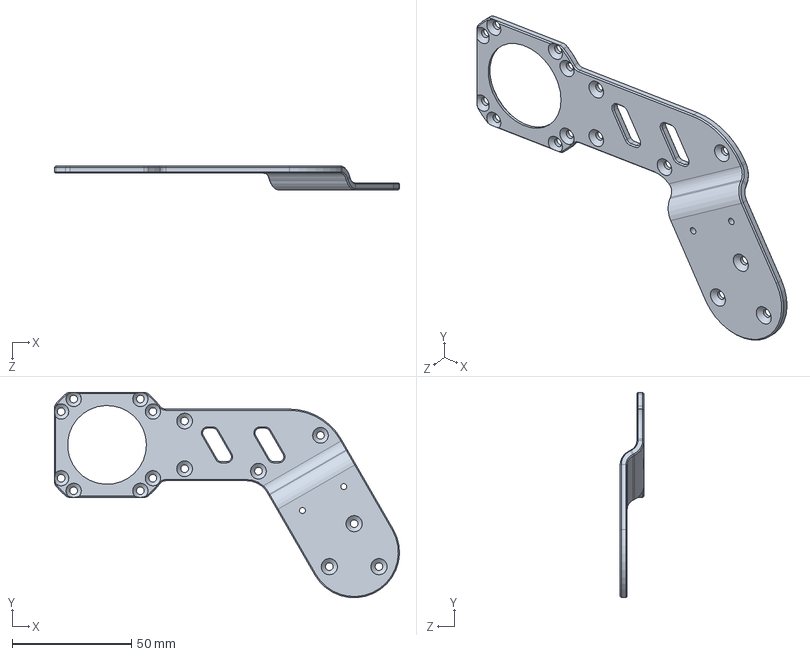
[picture p56: CAD file, 2026-07-28]
urdf模型/xlerobot/Link3_Connect_1免弯折.SLDPRT
144.5 x 86.0 x 10.0 mm
