lcg-l/HTDW_Opendog/urdf模型/HT-Pi-03C-BODY-02B-塑料箱体02.SLDPRT

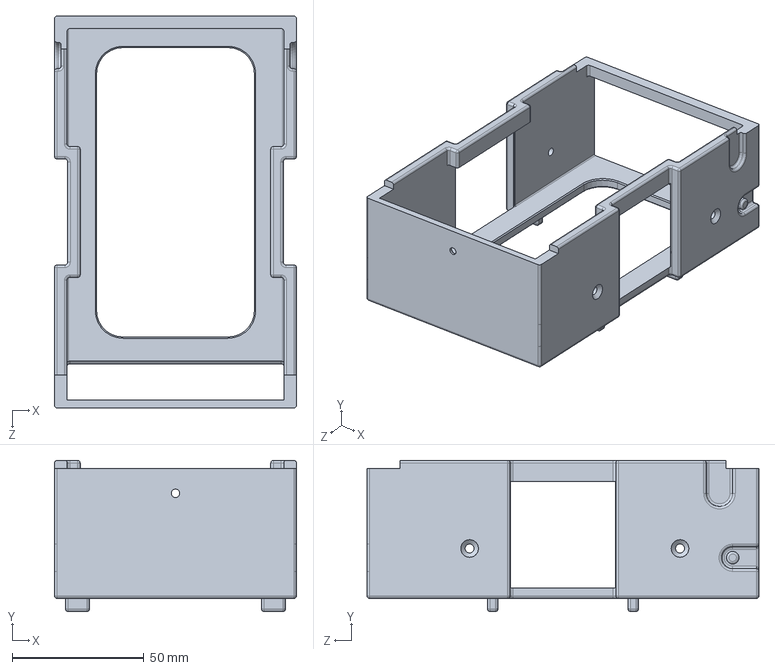
[picture p57: CAD file, 2026-07-28]
urdf模型/HT-Pi-03C-BODY-02B-塑料箱体02.SLDPRT
92.0 x 57.5 x 149.0 mm
