lcg-l/HTDW_Opendog/urdf模型/xlerobot/直齿条M2长50.SLDPRT

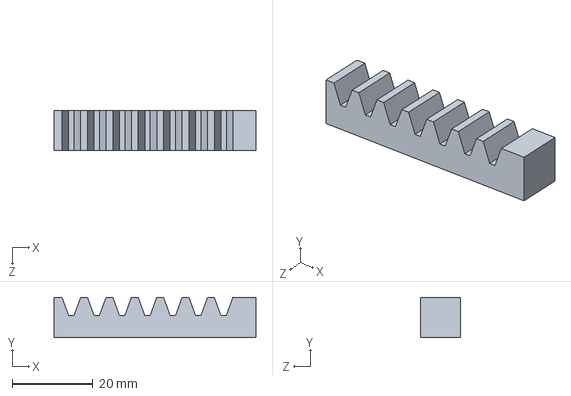
[picture p58: CAD file, 2026-07-28]
urdf模型/xlerobot/直齿条M2长50.SLDPRT
50.0 x 10.0 x 10.0 mm
