lcg-l/HTDW_Opendog/模型/xlerobot/Bearing17x26x5.SLDPRT

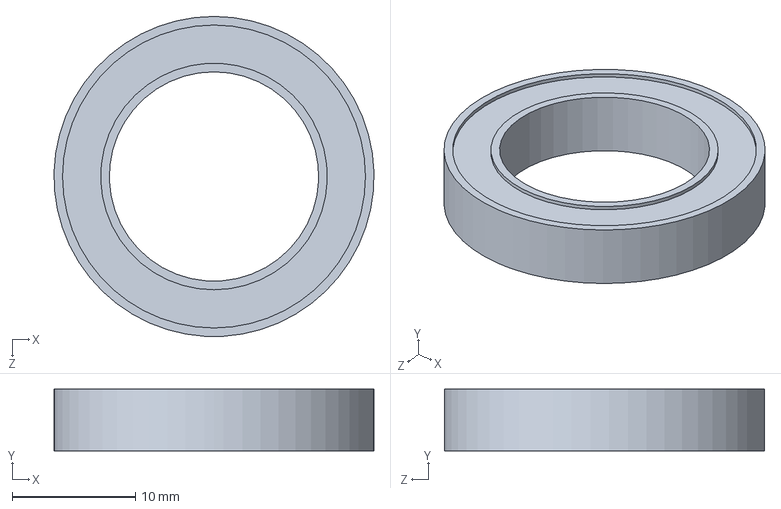
[picture p59: CAD file, 2026-07-28]
模型/xlerobot/Bearing17x26x5.SLDPRT
26.0 x 5.00 x 26.0 mm
