lcg-l/HTDW_Opendog/urdf模型/xlerobot/xlerobot-HT.SLDASM

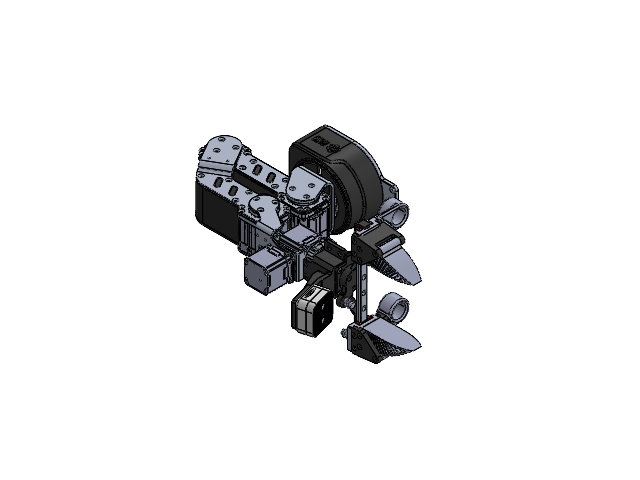
[picture p60: CAD file, 2026-08-31]
urdf模型/xlerobot/xlerobot-HT.SLDASM
Baselink_1
Baselink_C-3.0
L1_Inner_circleV2.0
底座带新LOGO丝印-
HTDW-4438-30-NE-JC
Link1_Connect_1
Link1_Connect_2
L1_Inner_circle_B
Link1_L1_D
4438_Rotor_block_1 x 3
4438_Stator_block_B x 3
Link2_Cover_A_V2.0
4438_model x 3
4438_Stator_block_1 x 3
Link2_Connect_1免弯折
Link2_Connect_2免弯折
Link2_Cover_B_V2.0免弯折
Bearing30x37x4 x 3
4438_Stator_block_B_2 x 3
Link3_Connect_3
Link3_Connect_1免弯折
Link3_Connect_2免弯折
Link3_Connect_B3免折弯
Link4_Connect_1
3536_model x 2
Link4_libe_buckle
Link6_Connect_1
2×6销轴
Link5_Connect_2改件
hightorque3536
Gripper_Connect_B
MGN9 Rail
Shoulder_Bolt_4xM3x7 x 4
Flanged_Bearing4x9x2.5 x 8
Gripper_Connect_A
hex_socket_flat_head_M3x08 x 4
hex_socket_low_button_head_M3x8 x 3
RealSense_D405
L6_Claw_insertsB
L6_Claw_insertsC
L6_Claw_insertsA
Link1_L6_A-
Gripper-Camera_Connect_A-
Gripper_Connect_E1.1 x 2
MGN9-C x 2
hex_socket_low_button_head_M3x5 x 8
Gripper_Connect_D x 2
Gripper_finger_Flexible_umi x 2
gripper_connect_R
gripper_connect_L
