lcg-l/HTDW_Opendog/urdf模型/箱体结构件.SLDASM

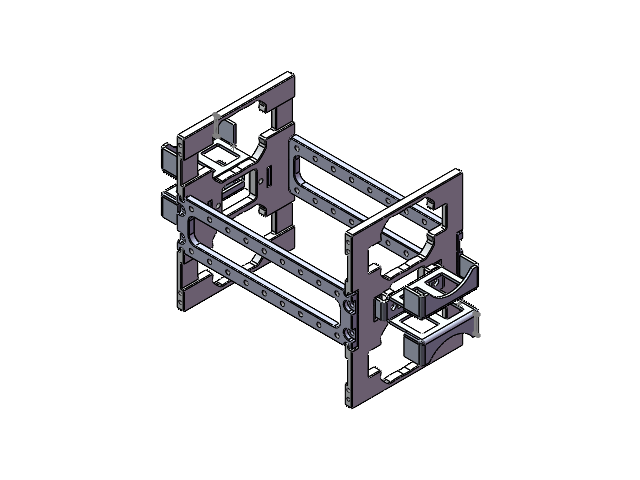
[picture p63: CAD file, 2026-09-02]
urdf模型/箱体结构件.SLDASM
横梁 x 2
箱体侧板 x 2
钣金快拆 x 2
钣金快拆垫块 x 4
