lcg-l/HTDW_Opendog/urdf模型/base.SLDASM

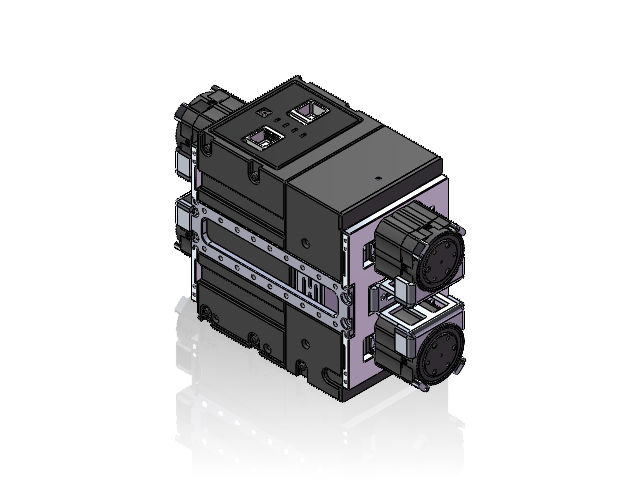
[picture p65: CAD file, 2026-09-02]
urdf模型/base.SLDASM
HT-Pi-03C-BODY-02B-塑料箱体02
主控盒子简化模型
上箱体挡板
HT-Pi-03C-BODY-04A-塑料箱体01
HT-PB-24PW-01B-电池上壳
HT-PB-24PW-02A-电池下壳
HT-PB-24PW-02A-电池卡舌 x 2
HT-PB-24PW-02B-电源按钮
HT-PB--24PW-01B-卡舌盖板
HT-PB-24PW-02A-电池内壳
M12开关
M16开关
HT-Pi-03C-BODY-01B-塑料箱体01_后盖
OLED背板
备用电池
横梁 x 2
箱体侧板 x 2
钣金快拆 x 2
钣金快拆垫块 x 4
4438-JC正装模型 x 4
限位块 x 8
