lcg-l/HTDW_Opendog/urdf模型/xlerobot/wrist2_link.SLDASM

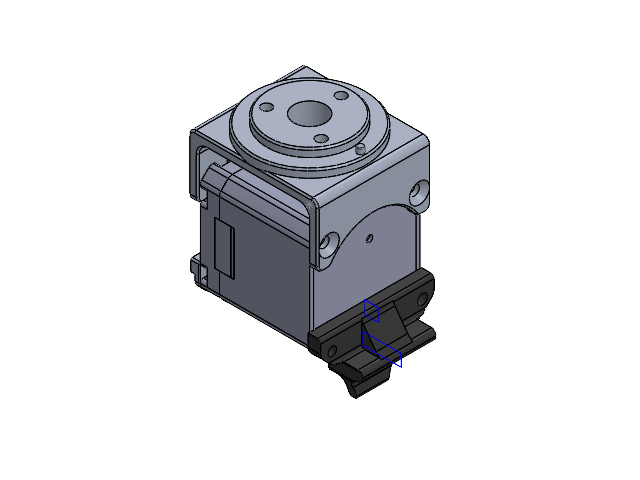
[picture p66: CAD file, 2026-08-31]
urdf模型/xlerobot/wrist2_link.SLDASM
3536_model
Link6_Connect_1
2×6销轴
Link5_Connect_2改件
