lcg-l/HTDW_Opendog/urdf模型/xlerobot/shoulder_link.SLDASM

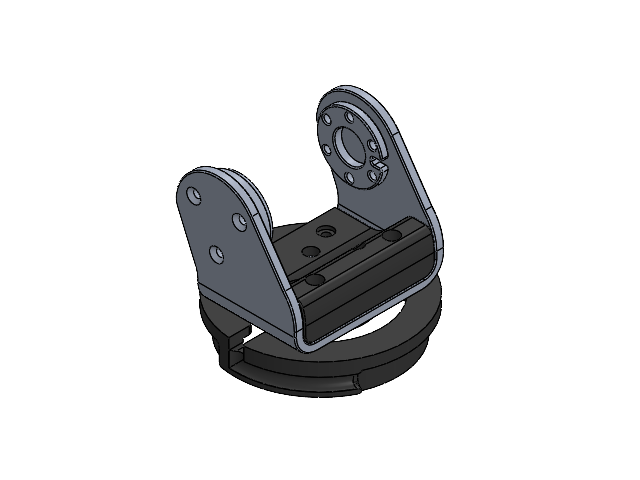
[picture p68: CAD file, 2026-08-31]
urdf模型/xlerobot/shoulder_link.SLDASM
Link1_Connect_1
Link1_Connect_2
L1_Inner_circle_B
Link1_L1_D
4438_Rotor_block_1
4438_Stator_block_B
