lcg-l/HTDW_Opendog/模型/总装.SLDASM

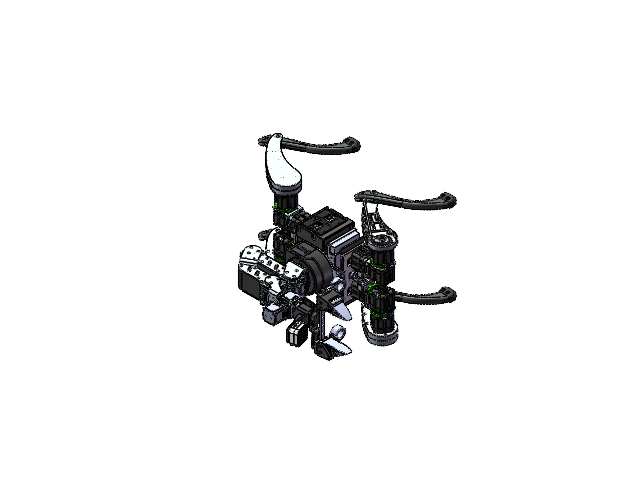
[picture p69: CAD file, 2026-09-02]
模型/总装.SLDASM
主控盒子简化模型
上箱体挡板
HT-Pi-03C-BODY-04A-塑料箱体01
HT-PB-24PW-01B-电池上壳
HT-PB-24PW-02A-电池下壳
HT-PB-24PW-02A-电池卡舌 x 2
HT-PB-24PW-02B-电源按钮
HT-PB--24PW-01B-卡舌盖板
HT-PB-24PW-02A-电池内壳
M12开关
M16开关
HT-Pi-03C-BODY-01B-塑料箱体01_后盖
OLED背板
备用电池
横梁 x 2
箱体侧板 x 2
钣金快拆 x 2
钣金快拆垫块 x 4
4438-JC正装模型 x 12
限位块 x 8
髋关节快拆 x 4
4530快拆法兰-A x 8
4530快拆法兰-B x 8
角接触球轴承 5x14x5（背对背） x 8
钢套5x7x4 x 8
微型滚针轴承 4x8x6 x 8
垫片4x12x0.5 x 4
摇臂 x 4
4530快拆法兰-C x 4
大腿内侧-L x 2
对锁螺母M4-22 x 4
对锁螺丝M4-22 x 4
对锁螺母M3-14 x 4
对锁螺丝M3-14 x 4
小腿 x 4
钢套4x6x3 x 8
钢连杆 x 4
foot x 4
大腿内侧-R x 2
大腿外侧-R x 2
大腿外侧-L
Baselink_1
Baselink_C-3.0
L1_Inner_circleV2.0
底座带新LOGO丝印-
HTDW-4438-30-NE-JC
Link1_Connect_1
Link1_Connect_2
L1_Inner_circle_B
Link1_L1_D
4438_Rotor_block_1 x 3
4438_Stator_block_B x 3
Link2_Cover_A_V2.0
4438_model x 3
4438_Stator_block_1 x 3
Link2_Connect_1免弯折
Link2_Connect_2免弯折
Link2_Cover_B_V2.0免弯折
Bearing30x37x4 x 3
4438_Stator_block_B_2 x 3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
