lcg-l/HTDW_Opendog/urdf模型/calf.SLDASM

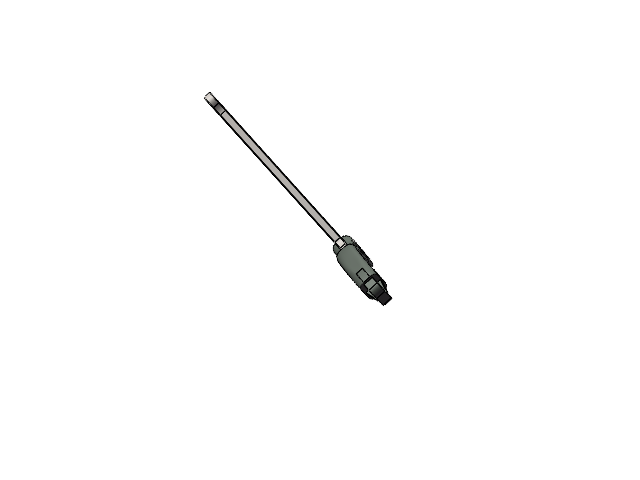
[picture p70: CAD file, 2026-08-31]
urdf模型/calf.SLDASM
对锁螺母M3-14
对锁螺丝M3-14
微型滚针轴承 4x8x6
小腿
钢套4x6x3 x 2
