lcg-l/HTDW_Opendog/urdf模型/xlerobot/wrist1_link.SLDASM

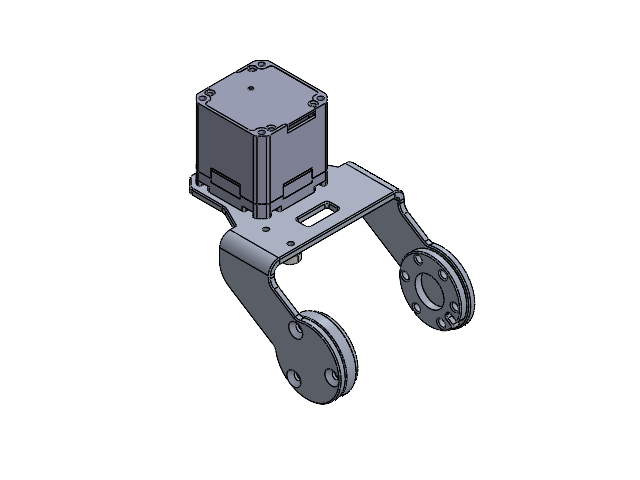
[picture p72: CAD file, 2026-08-31]
urdf模型/xlerobot/wrist1_link.SLDASM
Link4_Connect_1
4438_Rotor_block_1
3536_model
Link4_libe_buckle
4438_Stator_block_B
