lcg-l/HTDW_Opendog/urdf模型/xlerobot/wrist3_link.SLDASM

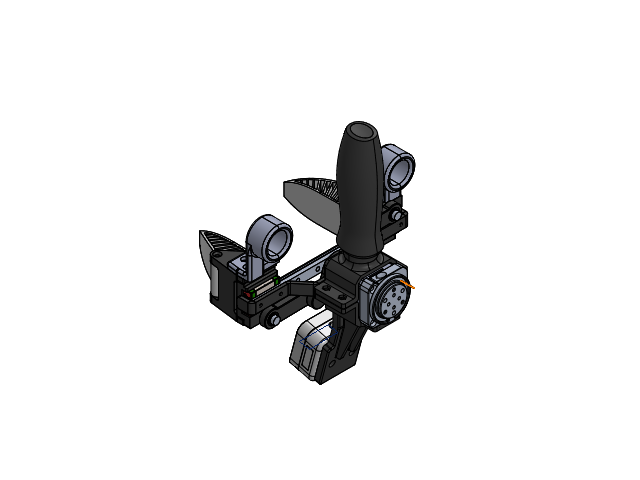
[picture p73: CAD file, 2026-08-31]
urdf模型/xlerobot/wrist3_link.SLDASM
hightorque3536
Gripper_Connect_B
MGN9 Rail
Shoulder_Bolt_4xM3x7 x 2
Flanged_Bearing4x9x2.5 x 4
Gripper_Connect_A
hex_socket_flat_head_M3x08 x 4
hex_socket_low_button_head_M3x8 x 3
RealSense_D405
L6_Claw_insertsB
L6_Claw_insertsC
L6_Claw_insertsA
Link1_L6_A-
Gripper-Camera_Connect_A-
