lcg-l/HTDW_Opendog/urdf模型/L_thigh.SLDASM

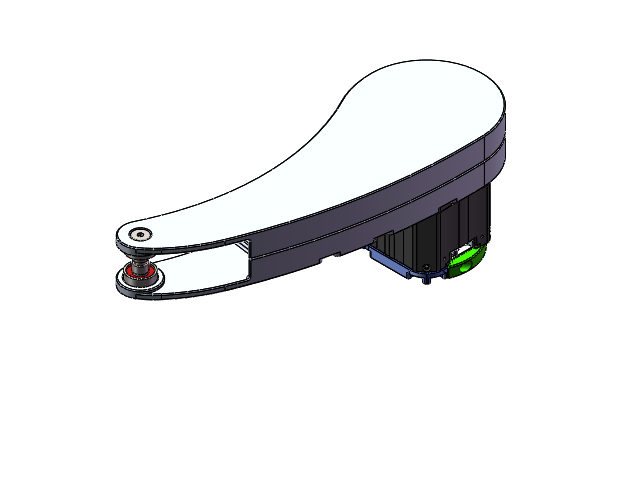
[picture p75: CAD file, 2026-08-31]
urdf模型/L_thigh.SLDASM
4438-JC正装模型
4530快拆法兰-A
角接触球轴承 5x14x5（背对背） x 2
钢套5x7x4 x 2
4530快拆法兰-B
微型滚针轴承 4x8x6
垫片4x12x0.5
摇臂
4530快拆法兰-C
大腿内侧-L
对锁螺母M4-22
对锁螺丝M4-22
大腿外侧-L
