lcg-l/HTDW_Opendog/urdf模型/xlerobot/base_link.SLDASM

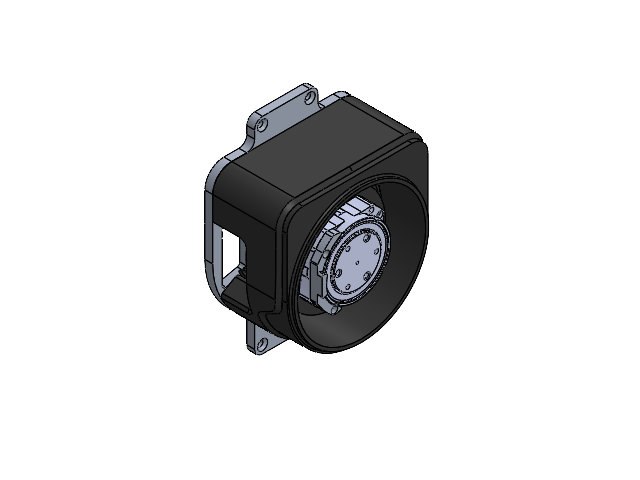
[picture p76: CAD file, 2026-08-31]
urdf模型/xlerobot/base_link.SLDASM
Baselink_1
Baselink_C-3.0
L1_Inner_circleV2.0
底座带新LOGO丝印-
HTDW-4438-30-NE-JC
