lcg-l/HTDW_Opendog/模型/HT-Pi-03C-BODY-后盖总成.SLDASM

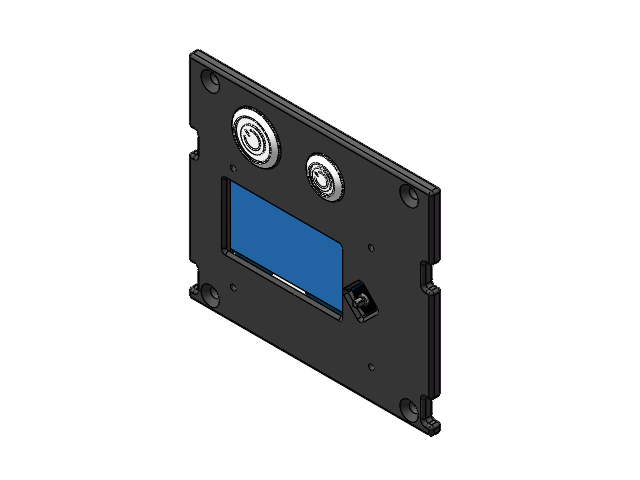
[picture p78: CAD file, 2026-07-22]
模型/HT-Pi-03C-BODY-后盖总成.SLDASM
M12开关
M16开关
HT-Pi-03C-BODY-01B-塑料箱体01_后盖
OLED背板
