lcg-l/HTDW_Opendog/模型/xlerobot/Gripper_Assembly.SLDASM

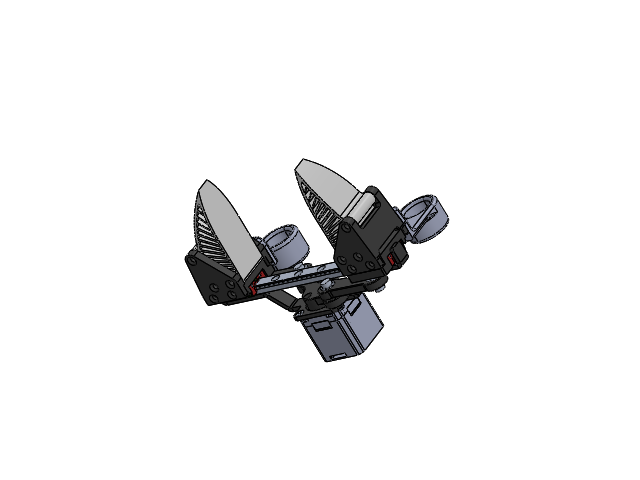
[picture p79: CAD file, 2026-07-28]
模型/xlerobot/Gripper_Assembly.SLDASM
hightorque3536
Gripper_Connect_B
MGN9 Rail
Gripper_Connect_C x 2
Shoulder_Bolt_4xM3x7 x 2
Flanged_Bearing4x9x2.5 x 4
Gripper_Connect_A
hex_socket_flat_head_M3x08 x 4
hex_socket_low_button_head_M3x8 x 3
