lcg-l/HTDW_Opendog/模型/base_down.SLDASM

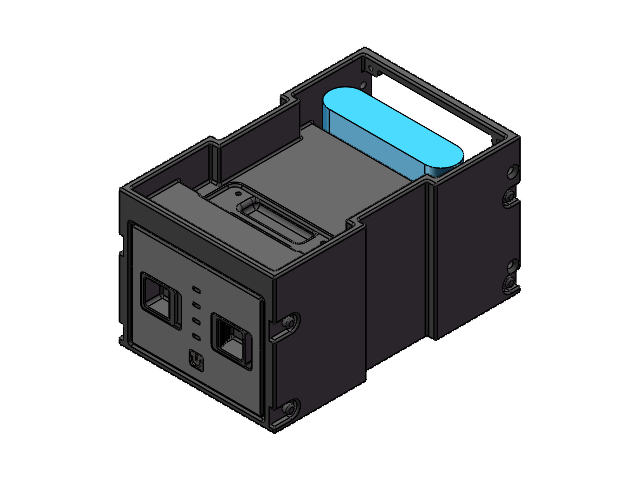
[picture p80: CAD file, 2026-07-22]
模型/base_down.SLDASM
HT-Pi-03C-BODY-04A-塑料箱体01
HT-PB-24PW-01B-电池上壳
HT-PB-24PW-02A-电池下壳
HT-PB-24PW-02A-电池卡舌 x 2
HT-PB-24PW-02B-电源按钮
HT-PB--24PW-01B-卡舌盖板
HT-PB-24PW-02A-电池内壳
备用电池
