lcg-l/HTDW_Opendog/模型/xlerobot/5036-02-正装.SLDASM

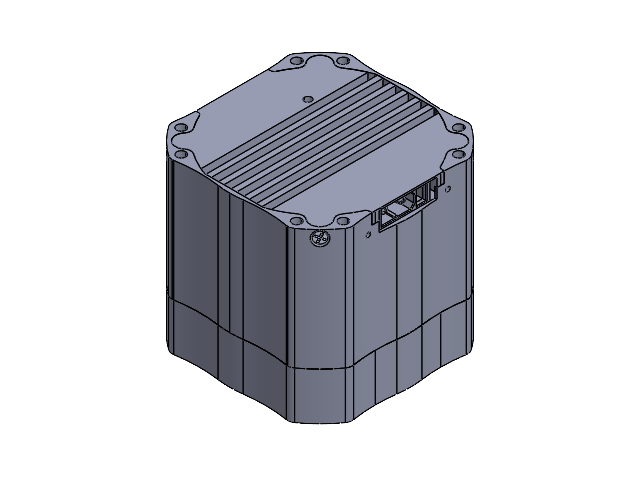
[picture p81: CAD file, 2026-07-28]
模型/xlerobot/5036-02-正装.SLDASM
5036-02-外壳-1.1.STEP
3D_双编-5047-V2.0.0418_2025-04-18.STEP
5036-02-电机盖-1.1.STEP
5036-02-正装轴承座-1.1.STEP
5036-02-二级8速比输出盘-非键槽-1.2.STEP
35-44-5橡胶密封型-6707 2rs.STEP
5047-编码器销-2.0.STEP
m3-6-4杯头螺丝.STEP x 3
5036-02-2行星轮销.STEP x 3
m2-4-3十字沉头螺丝.STEP x 4
M2.5-10-3.7杯头螺丝.STEP x 4
