lcg-l/HTDW_Opendog/模型/HT-PB-24vPowerbattery-03A.SLDASM

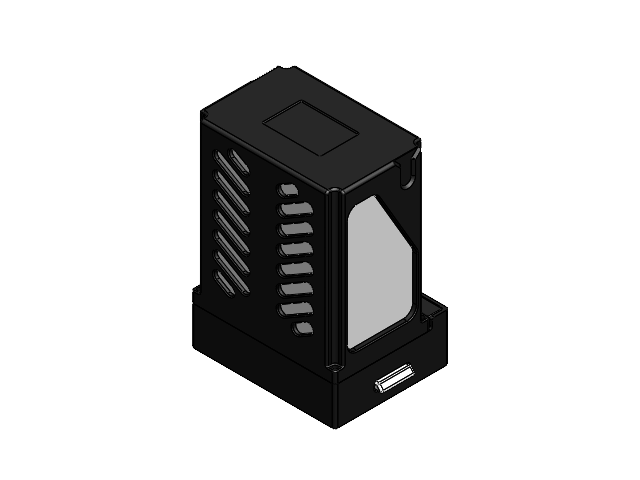
[picture p82: CAD file, 2026-07-22]
模型/HT-PB-24vPowerbattery-03A.SLDASM
HT-PB-24PW-01B-电池上壳
HT-PB-24PW-02A-电池下壳
HT-PB-24PW-02A-电池卡舌 x 2
HT-PB-24PW-02B-电源按钮
HT-PB--24PW-01B-卡舌盖板
HT-PB-24PW-02A-电池内壳
