lcg-l/HTDW_Opendog/模型/base_up.SLDASM

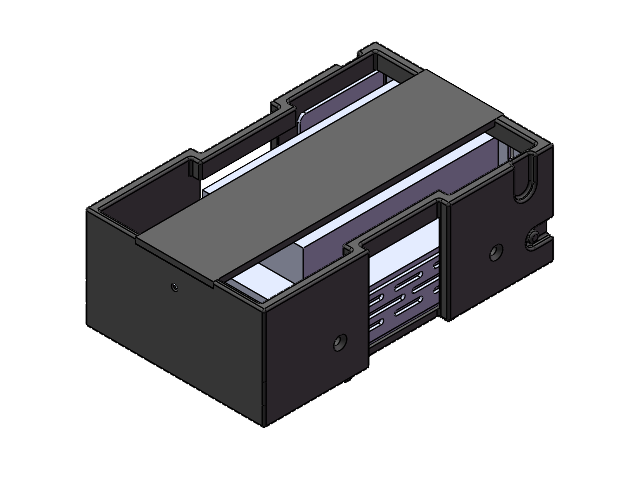
[picture p83: CAD file, 2026-07-22]
模型/base_up.SLDASM
HT-Pi-03C-BODY-02B-塑料箱体02
主控盒子简化模型
上箱体挡板
