lcg-l/HTDW_Opendog/模型/xlerobot/upper_arm_link.SLDASM

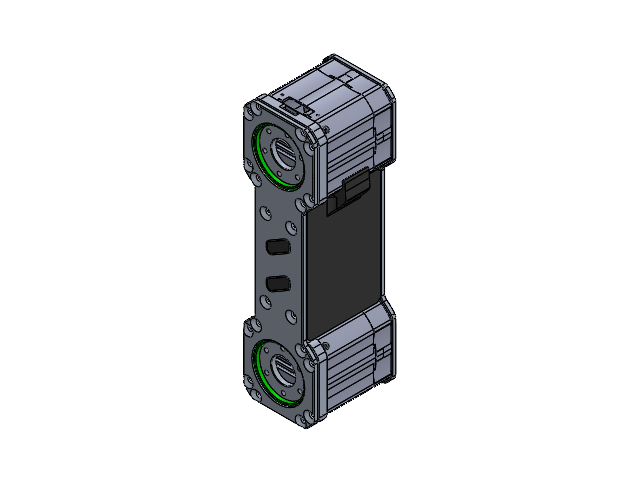
[picture p84: CAD file, 2026-07-28]
模型/xlerobot/upper_arm_link.SLDASM
Link2_Cover_A_V2.0
4438_model x 2
4438_Stator_block_1 x 2
Link2_Connect_1免弯折
Link2_Connect_2免弯折
Link2_Cover_B_V2.0免弯折
Bearing30x37x4 x 2
4438_Stator_block_B_2 x 2
