lcg-l/HTDW_Opendog/urdf模型/xlerobot/HTDW-4438-30-NE-JC.SLDASM

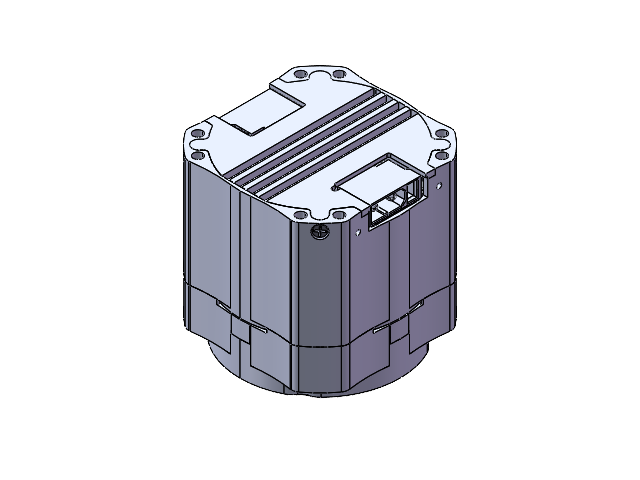
[picture p85: CAD file, 2026-07-28]
urdf模型/xlerobot/HTDW-4438-30-NE-JC.SLDASM
4438外壳03192.0.STEP
4438-电机盖-2.1.STEP
4438-jc轴承座-1.3.STEP
4438-jc输出盘.STEP
CRBT305A 30-41-5交叉滚子轴承.STEP
2内齿44382.0.STEP
3D_双编-4438-V1.9_2025-03-042.0.STEP
4438输出编码器销2.0_35.5.STEP
M2.5-10-3.7杯头螺丝.STEP x 4
m2-4-3十字沉头螺丝.STEP x 4
30-40-3旋转油封.STEP
