lcg-l/HTDW_Opendog/(list of files, cad)

Other CAD files:
模型/base.SLDASM
模型/箱体结构件.SLDASM
urdf模型/xlerobot/gripper_finger_left.SLDASM
urdf模型/xlerobot/gripper_finger_right.SLDASM
模型/L_thigh.SLDASM
urdf模型/hip.SLDASM
模型/xlerobot/base_link.SLDASM
模型/xlerobot/shoulder_link.SLDASM
模型/xlerobot/wrist3_link.SLDASM
模型/xlerobot/forearm_link.SLDASM
模型/xlerobot/wrist1_link.SLDASM
模型/xlerobot/gripper_finger_right.SLDASM
模型/xlerobot/gripper_finger_left.SLDASM
urdf模型/xlerobot/Gripper_Assembly.SLDASM
模型/xlerobot/wrist2_link.SLDASM
模型/钣金快拆.SLDPRT
ri_plus_4438/meshes/gripper_finger_left.STL
urdf模型/钣金快拆.SLDPRT
ri_4438/meshes/FL_hip.STL
ri_4438/meshes/FR_calf.STL
ri_plus_4438/meshes/RL_calf.STL
ri_4438/meshes/RL_calf.STL
ri_plus_4438/meshes/FR_foot.STL
ri_plus_4438/meshes/FL_hip.STL
四足-姚旋-5套/step/大腿外侧-L.step
ri_4438/meshes/RL_foot.STL
ri_4438/meshes/FL_calf.STL
ri_4438/meshes/FR_thigh.STL
ri_plus_4438/meshes/RR_thigh.STL
urdf模型/大腿限位块.SLDPRT
ri_4438/meshes/RR_thigh.STL
ri_plus_4438/meshes/RR_calf.STL
ri_4438/meshes/RL_thigh.STL
urdf模型/xlerobot/4438_Rotor_block_1.SLDPRT
四足-姚旋-5套/step/4530快拆法兰-A.step
ri_4438/meshes/base_link.STL
ri_plus_4438/meshes/RR_hip.STL
urdf模型/4530快拆法兰-B.SLDPRT
四足-姚旋-5套/step/大腿外侧-R.step
模型/大腿限位块.SLDPRT
ri_4438/meshes/RL_hip.STL
ri_plus_4438/meshes/RL_hip.STL
ri_4438/meshes/RR_foot.STL
ri_plus_4438/meshes/RL_thigh.STL
四足-姚旋-5套/step/大腿内侧-R.step
ri_4438/meshes/RR_calf.STL
urdf模型/摇臂.SLDPRT
模型/4530快拆法兰-B.SLDPRT
模型/xlerobot/外直齿轮M2Z30.SLDPRT
ri_4438/meshes/FR_hip.STL
ri_plus_4438/meshes/FR_thigh.STL
ri_4438/meshes/FR_foot.STL
ri_plus_4438/meshes/FL_calf.STL
ri_plus_4438/meshes/FL_foot.STL
ri_plus_4438/meshes/FL_thigh.STL
ri_plus_4438/meshes/RL_foot.STL
ri_plus_4438/meshes/RR_foot.STL
ri_plus_4438/meshes/forearm_link.STL
ri_plus_4438/meshes/upper_arm_link.STL
ri_plus_4438/meshes/wrist1_link.STL
urdf模型/4438-JC正装模型.SLDPRT
urdf模型/4530快拆法兰-A.SLDPRT
urdf模型/4530快拆法兰-C.SLDPRT
urdf模型/HT-PB--24PW-01B-卡舌盖板.SLDPRT
urdf模型/HT-PB-24PW-01B-电池上壳.SLDPRT
urdf模型/HT-PB-24PW-02A-电池下壳.SLDPRT
urdf模型/HT-PB-24PW-02A-电池内壳.SLDPRT
urdf模型/HT-PB-24PW-02A-电池卡舌.SLDPRT
urdf模型/HT-PB-24PW-02B-电源按钮.SLDPRT
urdf模型/HT-Pi-03C-BODY-01B-塑料箱体01_后盖.SLDPRT
urdf模型/HT-Pi-03C-BODY-04A-塑料箱体01.SLDPRT
urdf模型/M12开关.SLDPRT
urdf模型/M16开关.SLDPRT
urdf模型/OLED背板.SLDPRT
urdf模型/xlerobot/2×6销轴.SLDPRT
urdf模型/xlerobot/3536_model.SLDPRT
urdf模型/xlerobot/4438_Rotor_block_1.SLDDRW
urdf模型/xlerobot/4438_Stator_block_1.SLDDRW
urdf模型/xlerobot/4438_Stator_block_1.SLDPRT
urdf模型/xlerobot/4438_Stator_block_2.SLDDRW
urdf模型/xlerobot/4438_Stator_block_B.SLDDRW
urdf模型/xlerobot/4438_Stator_block_B.SLDPRT
urdf模型/xlerobot/4438_Stator_block_B_2.SLDDRW
urdf模型/xlerobot/4438_Stator_block_B_2.SLDPRT
urdf模型/xlerobot/4438_model.SLDPRT
urdf模型/xlerobot/5036-02-JC模型.SLDPRT
urdf模型/xlerobot/5036Rotor-Link_Connect.SLDDRW
urdf模型/xlerobot/5036Rotor-Link_Connect.SLDPRT
urdf模型/xlerobot/5036_Stator_block_1.SLDDRW
urdf模型/xlerobot/5036_Stator_block_1.SLDPRT
urdf模型/xlerobot/Baselink_1.SLDDRW
urdf模型/xlerobot/Baselink_1.SLDPRT
urdf模型/xlerobot/Baselink_C-3.0.SLDDRW
urdf模型/xlerobot/Baselink_C-3.0.SLDPRT
urdf模型/xlerobot/Bearing30x37x4.SLDPRT
urdf模型/xlerobot/Flanged_Bearing4x9x2.5.SLDPRT
urdf模型/xlerobot/Gripper-Camera_Connect_A-.SLDPRT
urdf模型/xlerobot/Gripper_Connect_A.SLDDRW
urdf模型/xlerobot/Gripper_Connect_A.SLDPRT
urdf模型/xlerobot/Gripper_Connect_B.SLDDRW
urdf模型/xlerobot/Gripper_Connect_B.SLDPRT
urdf模型/xlerobot/Gripper_Connect_C.SLDDRW
urdf模型/xlerobot/Gripper_Connect_C.SLDPRT
urdf模型/xlerobot/Gripper_Connect_D.SLDDRW
urdf模型/xlerobot/Gripper_Connect_D.SLDPRT
urdf模型/xlerobot/Gripper_Connect_E1.1.SLDPRT
urdf模型/xlerobot/Gripper_Connect_F.SLDPRT
urdf模型/xlerobot/Gripper_Connect_I.SLDPRT
urdf模型/xlerobot/Gripper_finger_Flexible_umi.SLDPRT
urdf模型/xlerobot/HTDW-4438-30-NE-JC.SLDPRT
urdf模型/xlerobot/L1_Inner_circleV2.0.SLDPRT
urdf模型/xlerobot/L1_Inner_circle_B.SLDPRT
urdf模型/xlerobot/L6_Claw_insertsA.SLDDRW
urdf模型/xlerobot/L6_Claw_insertsA.SLDPRT
urdf模型/xlerobot/L6_Claw_insertsB.SLDDRW
urdf模型/xlerobot/L6_Claw_insertsB.SLDPRT
urdf模型/xlerobot/L6_Claw_insertsC.SLDDRW
urdf模型/xlerobot/L6_Claw_insertsC.SLDPRT
urdf模型/xlerobot/Link1_Connect_1.SLDDRW
urdf模型/xlerobot/Link1_Connect_1.SLDPRT
urdf模型/xlerobot/Link1_Connect_2.SLDPRT
urdf模型/xlerobot/Link1_L1_D.SLDDRW
urdf模型/xlerobot/Link1_L1_D.SLDPRT
urdf模型/xlerobot/Link1_L6_A-.SLDDRW
urdf模型/xlerobot/Link1_L6_A-.SLDPRT
urdf模型/xlerobot/Link2_Connect_1.SLDDRW
urdf模型/xlerobot/Link2_Connect_1.SLDPRT
urdf模型/xlerobot/Link2_Connect_1免弯折.SLDDRW
urdf模型/xlerobot/Link2_Connect_1免弯折.SLDPRT
urdf模型/xlerobot/Link2_Connect_2.SLDDRW
urdf模型/xlerobot/Link2_Connect_2.SLDPRT
urdf模型/xlerobot/Link2_Connect_2免弯折.SLDDRW
urdf模型/xlerobot/Link2_Connect_2免弯折.SLDPRT
urdf模型/xlerobot/Link2_Cover_A_V2.0.SLDPRT
urdf模型/xlerobot/Link2_Cover_B_V2.0.SLDPRT
urdf模型/xlerobot/Link2_Cover_B_V2.0免弯折.SLDPRT
urdf模型/xlerobot/Link3_Connect_1.SLDDRW
urdf模型/xlerobot/Link3_Connect_1.SLDPRT
urdf模型/xlerobot/Link3_Connect_1免弯折.SLDDRW
urdf模型/xlerobot/Link3_Connect_2.SLDDRW
urdf模型/xlerobot/Link3_Connect_2.SLDPRT
urdf模型/xlerobot/Link3_Connect_2免弯折.SLDDRW
urdf模型/xlerobot/Link3_Connect_2免弯折.SLDPRT
urdf模型/xlerobot/Link4_Connect_1.SLDDRW
urdf模型/xlerobot/Link4_Connect_1.SLDPRT
urdf模型/xlerobot/Link4_libe_buckle.SLDPRT
urdf模型/xlerobot/Link5_Connect_1.SLDDRW
urdf模型/xlerobot/Link5_Connect_1.SLDPRT
urdf模型/xlerobot/Link5_Connect_2.SLDDRW
urdf模型/xlerobot/Link5_Connect_2.SLDPRT
urdf模型/xlerobot/Link5_Connect_2改件.SLDDRW
urdf模型/xlerobot/Link5_Connect_3.SLDPRT
urdf模型/xlerobot/Link6_Connect_1.SLDDRW
urdf模型/xlerobot/Link6_Connect_1.SLDPRT
urdf模型/xlerobot/MGN9 Rail.SLDPRT
urdf模型/xlerobot/MGN9-C.SLDPRT
urdf模型/xlerobot/MirrorGripper_Connect_I.SLDPRT
urdf模型/xlerobot/RealSense_D405.SLDPRT
urdf模型/xlerobot/Shoulder_Bolt_4xM3x7.SLDPRT
urdf模型/xlerobot/gripper_connect_L.SLDPRT
urdf模型/xlerobot/gripper_connect_R.SLDPRT
urdf模型/xlerobot/hex_socket_flat_head_M3x08.SLDPRT
urdf模型/xlerobot/hex_socket_low_button_head_M3x5.SLDPRT
urdf模型/xlerobot/hex_socket_low_button_head_M3x8.SLDPRT
urdf模型/xlerobot/hightorque3536.SLDPRT
urdf模型/xlerobot/xlerobot-HT.SLDDRW
urdf模型/xlerobot/六角螺母 M3.SLDPRT
urdf模型/xlerobot/内六角锥形沉头螺钉 M3x9.SLDPRT
urdf模型/xlerobot/外直齿轮M1.5Z18.SLDPRT
urdf模型/xlerobot/外直齿轮M1.5Z20.SLDPRT
urdf模型/xlerobot/外直齿轮M2Z18.SLDPRT
urdf模型/xlerobot/外直齿轮M2Z30.SLDPRT
urdf模型/xlerobot/底座带新LOGO丝印-.SLDPRT
urdf模型/xlerobot/线材端盖.SLDPRT
urdf模型/上箱体挡板.SLDPRT
urdf模型/主控盒子简化模型.SLDPRT
urdf模型/垫片4x12x0.5.SLDPRT
urdf模型/备用电池.SLDPRT
urdf模型/大腿内侧-L.SLDPRT
urdf模型/大腿内侧-R.SLDPRT
urdf模型/大腿外侧-L.SLDPRT
urdf模型/对锁螺丝M3-14.SLDPRT
urdf模型/对锁螺丝M4-22.SLDPRT
urdf模型/对锁螺母M3-14.SLDPRT
urdf模型/对锁螺母M4-22.SLDPRT
urdf模型/小腿.SLDPRT
urdf模型/微型滚针轴承 4x8x6.SLDPRT
urdf模型/横梁.SLDPRT
urdf模型/角接触球轴承 5x14x5（背对背）.SLDPRT
urdf模型/钢套4x6x3.SLDPRT
urdf模型/钢套5x7x4.SLDPRT
四足-姚旋-5套/dwg/4530快拆法兰-A.dwg
四足-姚旋-5套/dwg/4530快拆法兰-B.dwg
四足-姚旋-5套/dwg/4530快拆法兰-C.dwg
四足-姚旋-5套/dwg/大腿内侧-L.dwg
四足-姚旋-5套/dwg/大腿内侧-R.dwg
四足-姚旋-5套/dwg/大腿外侧-L.dwg
四足-姚旋-5套/dwg/大腿外侧-R.dwg
四足-姚旋-5套/dwg/大腿限位块.dwg
四足-姚旋-5套/dwg/摇臂.dwg
四足-姚旋-5套/dwg/横梁.dwg
四足-姚旋-5套/dwg/箱体侧板.dwg
四足-姚旋-5套/dwg/钢连杆.dwg
四足-姚旋-5套/dwg/钣金快拆.dwg
四足-姚旋-5套/dwg/钣金快拆垫块.DWG
四足-姚旋-5套/dwg/限位块.dwg
四足-姚旋-5套/dwg/髋关节快拆.dwg
图纸源文件/4530快拆法兰-A.SLDDRW
图纸源文件/4530快拆法兰-B.SLDDRW
图纸源文件/4530快拆法兰-C.SLDDRW
图纸源文件/大腿内侧-L.SLDDRW
图纸源文件/大腿内侧-R.SLDDRW
图纸源文件/大腿外侧-L.SLDDRW
图纸源文件/大腿外侧-R.SLDDRW
图纸源文件/大腿限位块.SLDDRW
图纸源文件/摇臂.SLDDRW
图纸源文件/横梁.SLDDRW
图纸源文件/箱体侧板.SLDDRW
图纸源文件/钢连杆.SLDDRW
图纸源文件/钣金快拆.SLDDRW
图纸源文件/钣金快拆垫块.SLDDRW
图纸源文件/限位块.SLDDRW
图纸源文件/髋关节快拆.SLDDRW
模型/4530快拆法兰-C.SLDPRT
模型/HT-PB--24PW-01B-卡舌盖板.SLDPRT
模型/HT-PB-24PW-01B-电池上壳.SLDPRT
模型/HT-PB-24PW-02A-电池下壳.SLDPRT
模型/HT-PB-24PW-02A-电池内壳.SLDPRT
模型/HT-PB-24PW-02A-电池卡舌.SLDPRT
模型/HT-PB-24PW-02B-电源按钮.SLDPRT
模型/HT-Pi-03C-BODY-01B-塑料箱体01_后盖.SLDPRT
模型/HT-Pi-03C-BODY-02B-塑料箱体02.SLDPRT
模型/HT-Pi-03C-BODY-04A-塑料箱体01.SLDPRT
模型/M12开关.SLDPRT
模型/M16开关.SLDPRT
模型/OLED背板.SLDPRT
模型/xlerobot/2×6销轴.SLDPRT
模型/xlerobot/3536_model.SLDPRT
模型/xlerobot/4438_Rotor_block_1.SLDDRW
模型/xlerobot/4438_Stator_block_1.SLDDRW
模型/xlerobot/4438_Stator_block_1.SLDPRT
模型/xlerobot/4438_Stator_block_2.SLDDRW
模型/xlerobot/4438_Stator_block_B.SLDDRW
模型/xlerobot/4438_Stator_block_B_2.SLDDRW
模型/xlerobot/4438_Stator_block_B_2.SLDPRT
模型/xlerobot/5036-02-JC模型.SLDPRT
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
