lcg-l/HTDW_Opendog/四足-姚旋-5套/pdf/4530快拆法兰-A.pdf

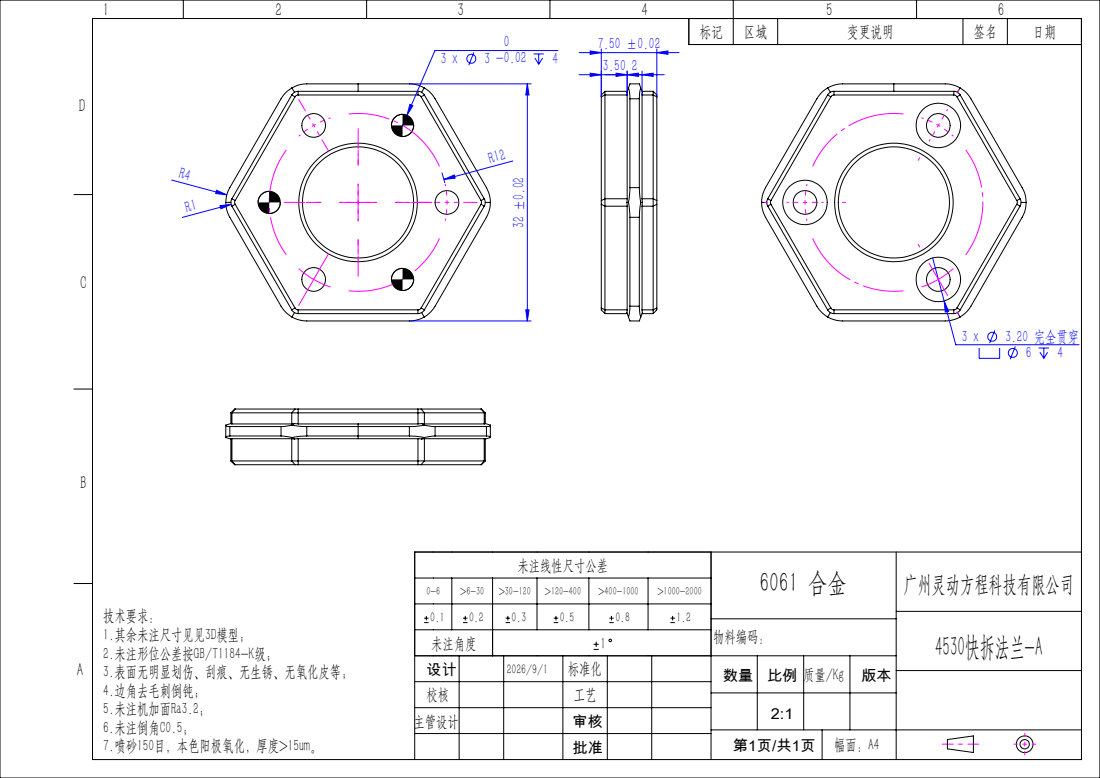
[picture p86: page 1]
3.20 完全贯穿; 广州灵动方程科技有限公司

标记 | 区域 | 变更说明 | 签名 | 日期

0-6 | >6-30 | >30-120 | >120-400 | >400-1000 | >1000-2000
0.1 | 0.2 | 0.3 | 0.5 | 0.8 | 1.2
