lcg-l/HTDW_Opendog/(commit log)

2026-06-28 Initial commit: Add HTDW_4438 Opendog project files
    [24V电池.SLDPRT, 304搭扣.SLDASM, 304搭扣1.SLDPRT, 304搭扣2.SLDPRT, 304搭扣3.SLDPRT, 304搭扣4.SLDPRT, 4438-侧装.SLDPRT, 4438-正装.SLDPRT]
2026-07-09 箱体修改，将4438替换为交滚版本
    [24V电池.SLDPRT, 304搭扣.SLDASM, 304搭扣1.SLDPRT, 304搭扣2.SLDPRT, 304搭扣3.SLDPRT, 304搭扣4.SLDPRT, 4438-JC正装模型.SLDPRT, 4438-侧装.SLDPRT]
2026-07-17 箱体改窄，髋关节快拆优化，快拆法兰改圆
    [4438-正装.SLDPRT, 4530快拆法兰-A.SLDPRT, 4530快拆法兰-B.SLDPRT, 4545-04-7.5速比输出盘-1.1.SLDPRT, 45舵.SLDASM, 45舵.SLDPRT, 45舵快拆.SLDPRT, CRBT305A 30-41-5交叉滚子轴承.SLDPRT]
2026-07-18 修复摇臂穿模，滚针轴承加垫片
    [4530快拆法兰-B.SLDPRT, 45舵.SLDASM, FL_thigh.SLDASM, FR_thigh.SLDASM, L_calf.SLDASM, RL_thigh.SLDASM, RR_thigh.SLDASM, R_calf.SLDASM]
2026-07-18 箱体修改，新增备用电池oled
    [HT-Pi-03C-BODY-02B-塑料箱体02.SLDPRT, HT-Pi-03C-BODY-04A-塑料箱体01.SLDPRT, HT-Pi-03C-BODY-后盖总成.SLDASM, OLED背板.SLDPRT, base.SLDASM, base_down.SLDASM, base_up.SLDASM, 备用电池.SLDPRT]
2026-07-20 箱体改宽，肘关节电机改回4438
    [4530快拆法兰-B.SLDPRT, FL_thigh.SLDASM, FR_thigh.SLDASM, HT-Pi-03C-BODY-02B-塑料箱体02.SLDPRT, HT-Pi-03C-BODY-04A-塑料箱体01.SLDPRT, L_calf.SLDASM, RL_thigh.SLDASM, RR_thigh.SLDASM]
2026-07-22 大小腿修改
    [4530快拆法兰-C.SLDPRT, 4545-04-7.5速比输出盘-1.1.SLDPRT, 45舵.SLDASM, 45舵.SLDPRT, 45舵快拆.SLDPRT, FL_thigh.SLDASM, FR_thigh.SLDASM, HT-Pi-03C-BODY-02B-塑料箱体02.SLDPRT]
2026-07-22 修改箱体走线
    [FL_thigh.SLDASM, HT-Pi-03C-BODY-04A-塑料箱体01.SLDPRT, L_thigh.SLDASM, base.SLDASM, base_down.SLDASM, hip.SLDASM, 总装.SLDASM]
2026-07-22 大小腿装配
    [L_calf.SLDASM, L_thigh.SLDASM, R_thigh.SLDASM, 大腿内侧-L.SLDPRT, 大腿内侧-R.SLDPRT, 大腿外侧-R.SLDPRT, 对锁螺丝M4-22.SLDPRT, 对锁螺母M4-22.SLDPRT]
2026-07-22 135°范围大腿修改
    [4530快拆法兰-B.SLDPRT, 4530快拆法兰-C.SLDPRT, HT-PB-24PW-01B-电池上壳.SLDPRT, HT-PB-24PW-02A-电池下壳.SLDPRT, HT-PB-24PW-02A-电池内壳.SLDPRT, HT-PB-24PW-02A-电池卡舌.SLDPRT, HT-PB-24vPowerbattery-03A.SLDASM, HT-Pi-03C-BODY-02B-塑料箱体02.SLDPRT]
2026-07-23 增加URDF
    [4438-JC正装模型.SLDPRT, 4530快拆法兰-A.SLDPRT, 4530快拆法兰-B.SLDPRT, 4530快拆法兰-C.SLDPRT, HT-PB--24PW-01B-卡舌盖板.SLDPRT, HT-PB-24PW-01B-电池上壳.SLDPRT, HT-PB-24PW-02A-电池下壳.SLDPRT, HT-PB-24PW-02A-电池内壳.SLDPRT]
2026-07-23 导出urdf，制作表格
    [24V电池.SLDPRT, 4438-JC正装模型.SLDPRT, 4438-正装.SLDPRT, 4438.urdf, 4530快拆法兰-A.SLDPRT, 4530快拆法兰-B.SLDPRT, 4530快拆法兰-C.SLDPRT, FL_calf.STL]
2026-07-23 规范名称问题
    [FL_calf.STL, FL_hip.STL, FL_thigh.STL, FR_calf.STL, FR_hip.STL, FR_thigh.STL, HTDW_4438.csv, HTDW_4438.urdf]
2026-07-24 修改大腿
    [L_calf.SLDASM, L_thigh.SLDASM, R_thigh.SLDASM, 大腿内侧-L.SLDPRT, 大腿内侧-R.SLDPRT, 大腿外侧-L.SLDPRT, 大腿外侧-R.SLDPRT, 小腿.SLDPRT]
2026-07-24 上传urdf模型
    [FL_calf.STL, FL_hip.STL, FL_thigh.STL, FR_calf.STL, FR_hip.STL, FR_thigh.STL, HTDW_4438.csv, HTDW_4438.urdf]
2026-07-26 修改urdf模型
    [4438-JC正装模型.SLDPRT, 4530快拆法兰-A.SLDDRW, 4530快拆法兰-A.SLDPRT, 4530快拆法兰-B.SLDDRW, 4530快拆法兰-B.SLDPRT, 4530快拆法兰-C.SLDDRW, 4530快拆法兰-C.SLDPRT, FL_calf.STL]
2026-07-26 更正urdf
    [FL_calf.STL, FL_foot.STL, FL_hip.STL, FL_thigh.STL, FR_calf.STL, FR_foot.STL, FR_hip.STL, FR_thigh.STL]
2026-07-27 上传工程图
    [4530快拆法兰-A.SLDDRW, 4530快拆法兰-B.SLDDRW, 4530快拆法兰-C.SLDDRW, 大腿内侧-L.SLDDRW, 大腿内侧-R.SLDDRW, 大腿外侧-L.SLDDRW, 大腿外侧-L.SLDPRT, 大腿外侧-R.SLDDRW]
2026-07-27 模型，图纸，装配修改
    [4438-JC正装模型.SLDPRT, 4530快拆法兰-A.SLDDRW, 4530快拆法兰-A.SLDPRT, 4530快拆法兰-B.SLDDRW, 4530快拆法兰-C.SLDDRW, L_calf.SLDASM, L_thigh.SLDASM, R_thigh.SLDASM]
2026-07-27 修改图纸，模型
    [4530快拆法兰-A.SLDDRW, 4530快拆法兰-B.SLDDRW, 4530快拆法兰-C.SLDDRW, 4530快拆法兰-C.SLDPRT, 四足-姚旋-5套.xlsx, 大腿内侧-L.SLDDRW, 大腿内侧-L.SLDPRT, 大腿内侧-R.SLDDRW]
2026-07-28 新增钣金快拆工程图
    [四足-姚旋-5套.xlsx, 总装.SLDASM, 钣金快拆.SLDDRW]
2026-07-28 修改图纸零件材料及加工数量
    [四足-姚旋-5套.xlsx, 小腿.SLDDRW, 小腿.dwg, 钢连杆.SLDDRW, 钢连杆.dwg, 钣金快拆.SLDDRW, 钣金快拆.dwg]
2026-07-28 修改加工数量为五套
    [四足-姚旋-5套.xlsx]
2026-07-28 模型姿态调整
    [4438-JC正装模型.SLDPRT, L_thigh.SLDASM, R_thigh.SLDASM, calf.SLDASM, hip.SLDASM, 四足-姚旋-5套.xlsx, 大腿内侧-L.SLDPRT, 大腿内侧-R.SLDPRT]
2026-08-03 工程改名，增加无机械臂版本的urdf
    [FL_calf.STL, FL_foot.STL, FL_hip.STL, FL_thigh.STL, FR_calf.STL, FR_foot.STL, FR_hip.STL, FR_thigh.STL]
2026-08-04 ri_plus urdf去掉指环
    [FL_calf.STL, FL_foot.STL, FL_hip.STL, FL_thigh.STL, FR_calf.STL, FR_foot.STL, FR_hip.STL, FR_thigh.STL]
2026-08-04 机械臂模型、颜色更改
    [gripper_finger_left.STL, gripper_finger_right.STL, ri_4438.urdf, ri_plus_4438.urdf, wrist3_link.STL]
2026-08-06 更换足端模型
    [foot.SLDPRT, 总装.SLDASM]
2026-08-23 更新xml，urdf身体简化为长方体
    [ri_4438.urdf]
2026-08-31 增加限位
    [4438-JC正装模型.SLDPRT, 4530快拆法兰-B.SLDPRT, L_thigh.SLDASM, R_thigh.SLDASM, base.SLDASM, base_link.SLDASM, calf.SLDASM, forearm_link.SLDASM]
2026-08-31 更新工程图
    [4530快拆法兰-B.SLDDRW, 4530快拆法兰-B.dwg, 4530快拆法兰-B.step, R_thigh.SLDASM, xlerobot-HT.SLDASM, 四足-姚旋-5套.xlsx, 大腿限位块.SLDDRW, 大腿限位块.SLDPRT]
2026-08-31 髋关节图纸更改
    [四足-姚旋-5套.xlsx, 髋关节快拆.SLDDRW, 髋关节快拆.dwg, 髋关节快拆.step]
2026-08-31 限位纠正
    [四足-姚旋-5套.xlsx, 大腿限位块.SLDDRW, 大腿限位块.dwg, 限位块.SLDDRW, 限位块.SLDPRT, 限位块.dwg, 限位块.step]
2026-08-31 urdf,模型更新，髋关节限位块位置调整
    [L_thigh.SLDASM, Link3_Connect_3.SLDPRT, Link3_Connect_B3免折弯.SLDPRT, R_thigh.SLDASM, base.SLDASM, calf.SLDASM, forearm_link.SLDASM, hip.SLDASM]
2026-09-02 钣金快拆修改
    [4530快拆法兰-A.SLDDRW, 4530快拆法兰-A.SLDPRT, 4530快拆法兰-A.dwg, 4530快拆法兰-B.SLDDRW, 4530快拆法兰-B.dwg, 4530快拆法兰-C.SLDDRW, 4530快拆法兰-C.dwg, base.SLDASM]
